phreakwiz/SNES-AddOn-PCBs/Classic_Multiregion_Mod_QID/Overview.JPG

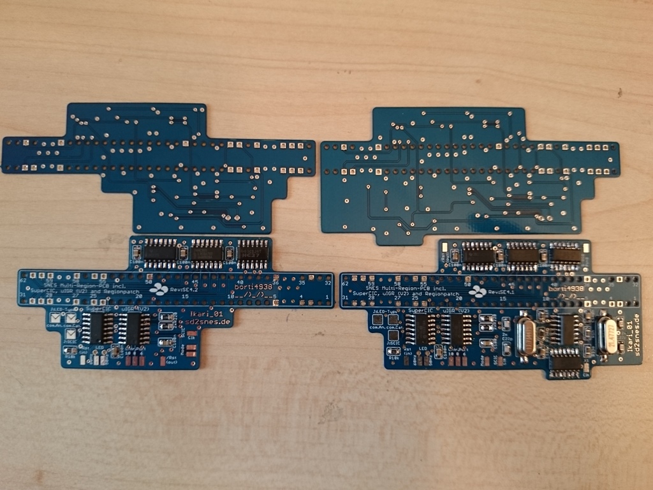
Classic_Multiregion_Mod_QID/Overview.JPG
