phreakwiz/SNES-AddOn-PCBs/RGB Bypass/3Chip-SNES/RGB_SNES.JPG

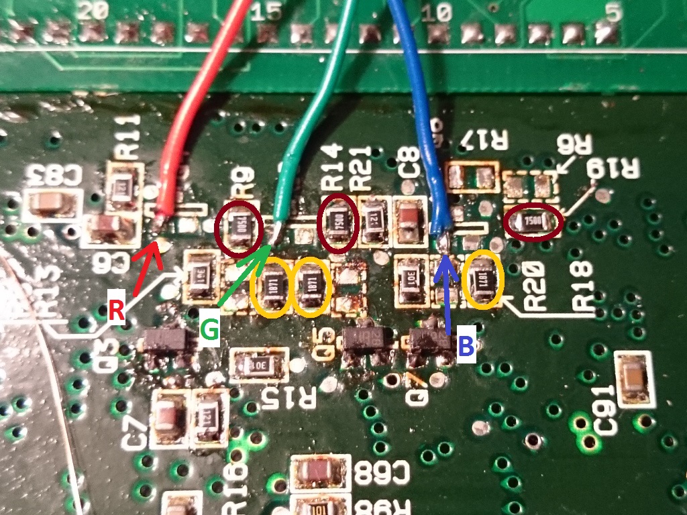
RGB Bypass/3Chip-SNES/RGB_SNES.JPG
