phreakwiz/SNES-AddOn-PCBs/MultiRegion_with_DeJitter_QID/BOM.xlsx

Sheet: SMR20200325
Version: | SMR20200325
Number of PCBs: |  |  | 3
Designator | MPN | QTY/PCB | QTY | DESCRIPTION | VALUE | PACKAGE | NOTES | Digikey | Mouser | Firmware
U1 | PIC16F630-I/SL | 1 | 3 | 8bit Microcontroller |  | SOIC-14 | needs SuperCIC-lock firmware preflashed |  |  | http://sd2snes.de/files/supercic.zip
U2 | PIC16F684-I/SL | 1 | 3 | 8bit Microcontroller |  | SOIC-14 | needs uIGR FW preflashed |  |  | https://github.com/borti4938/Switchless-Mods/tree/master/SNES/uigr_16f684
U3 | EPM7032AETC44-10N | 1 | 3 | CPLD, 32MCs, 3.3Vcc, 5V tolerant I/Os |  | TQFP44 | fw can be flashed using JTAG header |  |  | https://github.com/borti4938/snes_dejitter/tree/regionpatch%2Bdejitter/output_files
U4 | 74HCT2G125DP | 1 | 3 | IC BUFFER NON-INVERT with /OE |  | TSSOP8, SOT505-2
U5 | CDCE913PWR | 1 | 3 | IC PROG PLL VCXO CLK SYN |  | 14TSSOP | I2C accessable over PCB header |  |  | https://github.com/borti4938/SNES-AddOn-PCBs/tree/master/MultiRegion_with_DeJitter_QID/dfo/clockpro
U6 | SN74LVC2G17DBVR | 1 | 3 | IC BUFFER NON-INVERT, Schmitt Trigger |  | SOT-23-6
U7 | TLV70033DDCR | 1 | 3 | LDO 3.3V |  | SOT-23-5
U8 | TLV70018DDCR | 1 | 3 | LDO 1.8V |  | SOT-23-5
U9 | TSH122ICT | 1 | 3 | Video Driver, 6dB, 1 Ch. |  | SC-70-6
X1 | 9C-27.000MAAJ-T | 1 | 3 | CRYSTAL 27.0000MHZ 18PF | 27MHz | HC-49/US
C1,C94 | (22uF cap 0603) | 2 | 6 | Ceramic capacitor, X5R | 22uF / 16V | SMD0603
C11,C21,C31,C32,C33,C34,C41,C51,C52,C61 | (100nF cap 0603) | 10 | 30 | Ceramic capacitor, X7R | 0.1uF / 50V | SMD0603
C71,C72,C81,C82 | (1uF cap 0603) | 4 | 12 | Ceramic capacitor, X5R | 1uF / 6.3V | SMD0603
C91 | (10uF cap 0603) | 1 | 3 | Ceramic capacitor, X5R | 10uF / 25V | SMD0603
C92 | (10nF cap 0603) | 1 | 3 | Ceramic capacitor, X7R | 0.01uF / 50V | SMD0603
C93 | (33uF cap 0805) | 1 | 3 | Ceramic capacitor, X5R | 33uF / 5V | SMD0805
FB1,FB51 | MPZ1608S221A | 2 | 6 | Ferrit bead, power line |  | SMD0603
R11,R21,R32,R38,R39,R52,R63 | RC0603FR-0710KL | 7 | 21 | Resistor | 10k | SMD0603
R22,R23 | RC0603FR-07180RL | 2 | 6 | Resistor | 180 | SMD0603
R31,R37 | RC0603FR-071KL | 2 | 6 | Resistor | 1k | SMD0603
R51 | RC0603FR-0722KL | 1 | 3 | Resistor | 22k | SMD0603
R53,R54,R61 | RC0603FR-0739RL | 3 | 9 | Resistor | 39 | SMD0603
R62 |  | 0 | 0 | Resistor / Jumper |  | SMD0805 | resistor taken from SNES mainboard / jumper closed, if CClk.o directly connected to SNES
R91 | RC0603FR-074K7L | 1 | 3 | Resistor | 4.7k | SMD0603
R92 | RC0603FR-076K19L | 1 | 3 | Resistor | 6.19k | SMD0603
R93 | RC0603FR-07523RL | 1 | 3 | Resistor | 523 | SMD0603
R94 | RC0603FR-0775RL | 1 | 3 | Resistor | 75 | SMD0603
Optional components
(LED) | WP59SURKSGW | 1 | 3 | example replacement LED bi-color with common cathode | red / green
(pin header for LED connection) | 61900211021 | 1 | 3 | pin header for LED connection
 | 61900211621 | 1 | 3 | connector housing 2-pos. Female 2.54mm
 | 61900113722DEC | 2 | 6 | connector socket for 22-28AWG crimp

Sheet: SMR20190813
Version: | SMR20190813
Number of PCBs: |  |  | 3
Designator | MPN | QTY/PCB | QTY | DESCRIPTION | VALUE | PACKAGE | NOTES | Digikey | Mouser | Firmware
U1 | PIC16F630-I/SL | 1 | 3 | 8bit Microcontroller |  | SOIC-14 | needs SuperCIC-lock firmware preflashed |  |  | http://sd2snes.de/files/supercic.zip
U2 | PIC16F684-I/SL | 1 | 3 | 8bit Microcontroller |  | SOIC-14 | needs uIGR FW preflashed |  |  | https://github.com/borti4938/Switchless-Mods/tree/master/SNES/uigr_16f684
U3 | EPM7032AETC44-10N | 1 | 3 | CPLD, 32MCs, 3.3Vcc, 5V tolerant I/Os |  | TQFP44 | fw can be flashed using JTAG header |  |  | https://github.com/borti4938/snes_dejitter/tree/regionpatch%2Bdejitter/output_files
U4 | 74HCT2G125DP | 1 | 3 | IC BUFFER NON-INVERT with /OE |  | TSSOP8, SOT505-2
U5 | CDCE913PWR | 1 | 3 | IC PROG PLL VCXO CLK SYN |  | 14TSSOP | I2C accessable over PCB header |  |  | https://github.com/borti4938/SNES-AddOn-PCBs/tree/master/MultiRegion_with_DeJitter_QID/dfo/clockpro
U6 | SN74LVC2G17DBVR | 1 | 3 | IC BUFFER NON-INVERT, Schmitt Trigger |  | SOT-23-6
U7 | TLV70033DDCR | 1 | 3 | LDO 3.3V |  | SOT-23-5
U8 | TLV70018DDCR | 1 | 3 | LDO 1.8V |  | SOT-23-5
Q31 | 2SC2412KT146R | 1 | 3 | TRANS NPN 50V 0.15A |  | TO-236-3, SC-59, SOT-23-3
X1 | 9C-27.000MAAJ-T | 1 | 3 | CRYSTAL 27.0000MHZ 18PF | 27MHz | HC-49/US
C1 | (22uF cap 0805) | 1 | 3 | Ceramic capacitor, X5R | 22uF / 16V | SMD0805
C11,C21,C31,C32,C33,C34,C41,C51,C52,C61 | (100nF cap 0603) | 10 | 30 | Ceramic capacitor, X7R | 0.1uF / 50V | SMD0603
C71,C72,C81,C82 | (1uF cap 0603) | 4 | 12 | Ceramic capacitor, X5R | 1uF / 6.3V | SMD0603
FB1,FB51 | MPZ1608S221A | 2 | 6 | Ferrit bead, power line |  | SMD0603
R11,R21,R32,R34,R38,R39,R52 | RC0603FR-0710KL | 7 | 21 | Resistor | 10k | SMD0603
R22,R23 | RC0603FR-07180RL | 2 | 6 | Resistor | 180 | SMD0603
R31,R33,R37 | RC0603FR-071KL | 3 | 9 | Resistor | 1k | SMD0603
R35 | RC0603FR-07300RL | 1 | 3 | Resistor | 300 | SMD0603
R36 | RC0603FR-07100RL | 1 | 3 | Resistor | 100 | SMD0603
R51 | RC0603FR-0722KL | 1 | 3 | Resistor | 22k | SMD0603
R53,R54,R61 | RC0603FR-0739RL | 3 | 9 | Resistor | 39 | SMD0603
R62 |  | 0 | 0 | Resistor / Jumper |  | SMD0805 | resistor taken from SNES mainboard / jumper closed, if CClk.o directly connected to SNES
Optional components
(LED) | WP59SURKSGW | 1 | 3 | example replacement LED bi-color with common cathode | red / green
(pin header for LED connection) | 61900211021 | 1 | 3 | pin header for LED connection
 | 61900211621 | 1 | 3 | connector housing 2-pos. Female 2.54mm
 | 61900113722DEC | 2 | 6 | connector socket for 22-28AWG crimp

Sheet: SMR20190603
Version: | SMR20190603 | (and earlier)
Number of PCBs: |  |  | 3
Designator | MPN | QTY/PCB | QTY | DESCRIPTION | VALUE | PACKAGE | NOTES | Digikey | Mouser | Firmware
U1 | PIC16F630-I/SL | 1 | 3 | 8bit Microcontroller |  | SOIC-14 | needs SuperCIC-lock firmware preflashed |  |  | http://sd2snes.de/files/supercic.zip
U2 | PIC16F684-I/SL | 1 | 3 | 8bit Microcontroller |  | SOIC-14 | needs uIGR FW preflashed |  |  | https://github.com/borti4938/Switchless-Mods/tree/master/SNES/uigr_16f684
U3 | EPM7032AETC44-10N | 1 | 3 | CPLD, 32MCs, 3.3Vcc, 5V tolerant I/Os |  | TQFP44 | fw can be flashed using JTAG header |  |  | https://github.com/borti4938/snes_dejitter/tree/regionpatch%2Bdejitter/output_files
U4 | 74HCT2G125DP | 1 | 3 | IC BUFFER NON-INVERT with /OE |  | TSSOP8, SOT505-2
U5 | CDCE913PWR | 1 | 3 | IC PROG PLL VCXO CLK SYN |  | 14TSSOP | I2C accessable over PCB header |  |  | https://github.com/borti4938/SNES-AddOn-PCBs/tree/master/MultiRegion_with_DeJitter_QID/dfo/clockpro
U6 | SN74LVC2G17DBVR | 1 | 3 | IC BUFFER NON-INVERT, Schmitt Trigger |  | SOT-23-6
U7 | TLV70033DDCR | 1 | 3 | LDO 3.3V |  | SOT-23-5
U8 | TLV70018DDCR | 1 | 3 | LDO 1.8V |  | SOT-23-5
Q31 | 2SC2412KT146R | 1 | 3 | TRANS NPN 50V 0.15A |  | TO-236-3, SC-59, SOT-23-3
X1 | 9C-27.000MAAJ-T | 1 | 3 | CRYSTAL 27.0000MHZ 18PF | 27MHz | HC-49/US
C1 | (22uF cap 0805) | 1 | 3 | Ceramic capacitor, X5R | 22uF / 16V | SMD0805
C11,C21,C31,C32,C33,C34,C41,C51,C52,C61 | (100nF cap 0603) | 10 | 30 | Ceramic capacitor, X7R | 0.1uF / 50V | SMD0603
C71,C72,C81,C82 | (1uF cap 0603) | 4 | 12 | Ceramic capacitor, X5R | 1uF / 6.3V | SMD0603
FB1,FB51 | MPZ1608S221A | 2 | 6 | Ferrit bead, power line |  | SMD0603
R11,R21,R32,R34,R38,R39,R52 | RC0603FR-0710KL | 7 | 21 | Resistor | 10k | SMD0603
R22,R23 | RC0603FR-07180RL | 2 | 6 | Resistor | 180 | SMD0603
R31,R33,R37 | RC0603FR-071KL | 3 | 9 | Resistor | 1k | SMD0603
R35 | RC0603FR-07300RL | 1 | 3 | Resistor | 300 | SMD0603
R36 | RC0603FR-07100RL | 1 | 3 | Resistor | 100 | SMD0603
R51 | RC0603FR-0722KL | 1 | 3 | Resistor | 22k | SMD0603
RN53,RN61 | CAY16-39R0F4LF | 2 | 6 | Resistor-Array | 39 | SMD1206 | Alternatives with 5% tolerance are sufficient
Optional components
(LED) | WP59SURKSGW | 1 | 3 | example replacement LED bi-color with common cathode | red / green
(pin header for LED connection) | 61900211021 | 1 | 3 | pin header for LED connection
 | 61900211621 | 1 | 3 | connector housing 2-pos. Female 2.54mm
 | 61900113722DEC | 2 | 6 | connector socket for 22-28AWG crimp
