phreakwiz/SNES-AddOn-PCBs/RGB Bypass/BOM_SNES_RGB_bypass.xlsx

Sheet: SNES_RGBAmp
Designator | MPN | QTY | DESCRIPTION | VALUE | PACKAGE | NOTES
U1 | THS7374IPWR | 1 | 4Ch. Video Amp with SD-filters (selectable) |  | 14TSSOP
 | THS7373IPWR |  | 4Ch. Video Amp with one SD-filte and three HD-filters (selectable) |  | 14TSSOP | Alternative to THS7374
 | THS7314DR |  | 3Ch. SD Video Amp |  | 8-SOIC | Alternative to THS7374 (not recommended)
 | THS7316 |  | 3Ch. HD Video Amp |  | 8-SOIC | Alternative to THS7374 (not recommended)
C1 | GRM188R71H104KA93J | 1 | Ceramic capacitor, X7R | 0.1uF +/- 10% / 50V | SMD0603
C2 | GRM31CR60J226KE19L | 1 | Ceramic capacitor, X5R | 22uF +/- 10% / 6.3V | SMD1206
 | TAJB226K020RNJ |  | Tantalum capacitor | 22uF +/- 10% / 20V | SMD1411 | 3.50mm x 2.80mm, alternative to ceramic 22uF capacitor
R1 | RC0603FR-074K99L | 1 | Resistor | 4.99kOhm, 0.1W | SMD0603 | Non-critical value: other values around 4.99k can be used
C11,C21,C31 | C0603C823K4RACTU | 3 | Ceramic capacitor, X7R | 0.082uF +/- 10% / 16V | SMD0603
R12,R22,R32 | CRCW06035M10FKEA | 3 | Resistor | 5.1MOhm, 0.1W | SMD0603
R13,R23,R33 | RC0603FR-0775RL | 3 | Resistor | 75Ohm, 0.1W | SMD0603 | For NTSC cable setup
 | RC0603FR-0739RL |  | Resistor | 39Ohm, 0.1W | SMD0603 | Alternative for PAL cable setup
C14,C24,C34 | CL10C470JB8NNNC | see readme | Ceramic capacitor, C0G/NP0 | 47pF +/-5% / 50V | SMD0603 | Decoupling caps on modding board
R11,R21,R31 | RC0603FR-07750RL | see readme | Resistor | 750Ohm, 0.1W | SMD0603 | Resolving brightness issue (common choice for big model 1Chip)
 | RC0603FR-071K2L |  |  | 1.2kOhm, 0.1W |  | Resolving brightness issue (common choice for SNES2 (Mini/Jr.))
MPNs are only suggestions! You can use equivalent components, too.

Sheet: SNES_RGBAmp_wCSYNC
Designator | MPN | QTY | DESCRIPTION | VALUE | PACKAGE | NOTES
U1 | THS7374IPWR | 1 | 4Ch. Video Amp with SD-filters (selectable) |  | 14TSSOP
 | THS7373IPWR |  | 4Ch. Video Amp with one SD-filte and three HD-filters (selectable) |  | 14TSSOP | Alternative to THS7374
C1 | GRM188R71H104KA93J | 1 | Ceramic capacitor, X7R | 0.1uF +/- 10% / 50V | SMD0603
C2 | GRM31CR60J226KE19L | 1 | Ceramic capacitor, X5R | 22uF +/- 10% / 6.3V | SMD1206
 | TAJB226K020RNJ |  | Tantalum capacitor | 22uF +/- 10% / 20V | SMD1411 | 3.50mm x 2.80mm, alternative to ceramic 22uF capacitor
R1 | RC0603FR-074K99L | 1 | Resistor | 4.99kOhm, 0.1W | SMD0603 | Non-critical value: other values around 4.99k can be used
C11,C21,C31 | C0603C823K4RACTU | 3 | Ceramic capacitor, X7R | 0.082uF +/- 10% / 16V | SMD0603
R12,R22,R32 | CRCW06035M10FKEA | 3 | Resistor | 5.1MOhm, 0.1W | SMD0603
R13,R23,R33 | RC0603FR-0775RL | 3 | Resistor | 75Ohm, 0.1W | SMD0603 | For NTSC cable setup
 | RC0603FR-0739RL |  | Resistor | 39Ohm, 0.1W | SMD0603 | Alternative for PAL cable setup
C14,C24,C34 | CL10C470JB8NNNC | see readme | Ceramic capacitor, C0G/NP0 | 47pF +/-5% / 50V | SMD0603 | Decoupling caps on modding board
R11,R21,R31 | RC0603FR-07750RL | see readme | Resistor | 750Ohm, 0.1W | SMD0603 | Resolving brightness issue (common choice for big model 1Chip)
 | RC0603FR-071K2L |  |  | 1.2kOhm, 0.1W |  | Resolving brightness issue (common choice for SNES2 (Mini/Jr.))
/CSYNC branch: 75ohm compatible setup (see notes in readme)
R41 | RC0603FR-079K53L | 1 | Resistor | 9.53kOhm, 0.1W | SMD0603
R42 | RC0603FR-07620RL | 1 | Resistor | 620Ohm, 0.1W | SMD0603
C43 | T491D337K006AT | 1 | Tantalum capacitor | 330uF +/- 10% / 6.3V | SMD2917 | 7,30 mm x 4,30 mm
 | T491D227K006AT | 1 | Tantalum capacitor | 220uF +/- 10% / 6.3V | SMD2917 | 7,30 mm x 4,30 mm, alternative to the 330uF tantalum capacitor
R43 | RC0603FR-0775RL | 1 | Resistor | 75Ohm, 0.1W | SMD0603
C44 | CL10C470JB8NNNC | see readme | Ceramic capacitor, C0G/NP0 | 47pF +/-5% / 50V | SMD0603 | Decoupling caps on modding board
/CSYNC branch: TTL compatible setup (see notes in readme)
R41 | RC0603FR-074K99L | 1 | Resistor | 4.99kOhm, 0.1W | SMD0603
R42 | RC0603FR-074K3L | 1 | Resistor | 4.30kOhm, 0.1W | SMD0603
C43 |  |  |  |  |  | Short with J2
R43 | RC0603FR-0775RL | 1 | Resistor | 75Ohm, 0.1W | SMD0603
 | Short |  |  |  |  | Alternative to the 75Ohm resistor
C44 | CL10C470JB8NNNC | see readme | Ceramic capacitor, C0G/NP0 | 47pF +/-5% / 50V | SMD0603 | Decoupling caps on modding board
MPNs are only suggestions! You can use equivalent components, too.

Sheet: SNES_RGBAmp_wCSYNC_SVid
Designator | MPN | QTY | DESCRIPTION | VALUE | PACKAGE | NOTES
U1 | THS7374IPWR | 1 | 4Ch. Video Amp with SD-filters (selectable) |  | 14TSSOP
 | THS7373IPWR |  | 4Ch. Video Amp with one SD-filte and three HD-filters (selectable) |  | 14TSSOP | Alternative to THS7374
C1 | GRM188R71H104KA93J | 1 | Ceramic capacitor, X7R | 0.1uF +/- 10% / 50V | SMD0603
C2 | GRM31CR60J226KE19L | 1 | Ceramic capacitor, X5R | 22uF +/- 10% / 6.3V | SMD1206
 | TAJB226K020RNJ |  | Tantalum capacitor | 22uF +/- 10% / 20V | SMD1411 | 3.50mm x 2.80mm, alternative to ceramic 22uF capacitor
R1 | RC0603FR-074K99L | 1 | Resistor | 4.99kOhm, 0.1W | SMD0603 | Non-critical value: other values around 4.99k can be used
C11,C21,C31 | C0603C823K4RACTU | 3 | Ceramic capacitor, X7R | 0.082uF +/- 10% / 16V | SMD0603
R12,R22,R32 | CRCW06035M10FKEA | 3 | Resistor | 5.1MOhm, 0.1W | SMD0603
R13,R23,R33 | RC0603FR-0775RL | 3 | Resistor | 75Ohm, 0.1W | SMD0603 | For NTSC cable setup
 | RC0603FR-0739RL |  | Resistor | 39Ohm, 0.1W | SMD0603 | Alternative for PAL cable setup
C14,C24,C34 | CL10C470JB8NNNC | see readme | Ceramic capacitor, C0G/NP0 | 47pF +/-5% / 50V | SMD0603 | Decoupling caps on modding board
R11,R21,R31 | RC0603FR-07750RL | see readme | Resistor | 750Ohm, 0.1W | SMD0603 | Resolving brightness issue (common choice for big model 1Chip)
 | RC0603FR-071K2L |  |  | 1.2kOhm, 0.1W |  | Resolving brightness issue (common choice for SNES2 (Mini/Jr.))
/CSYNC branch: 75ohm compatible setup (see notes in readme)
R41 | RC0603FR-079K53L | 1 | Resistor | 9.53kOhm, 0.1W | SMD0603
R42 | RC0603FR-07620RL | 1 | Resistor | 620Ohm, 0.1W | SMD0603
C43 | T491D337K006AT | 1 | Tantalum capacitor | 330uF +/- 10% / 6.3V | SMD2917 | 7,30 mm x 4,30 mm
 | T491D227K006AT | 1 | Tantalum capacitor | 220uF +/- 10% / 6.3V | SMD2917 | 7,30 mm x 4,30 mm, alternative to the 330uF tantalum capacitor
R43 | RC0603FR-0775RL | 1 | Resistor | 75Ohm, 0.1W | SMD0603
C44 | CL10C470JB8NNNC | see readme | Ceramic capacitor, C0G/NP0 | 47pF +/-5% / 50V | SMD0603 | Decoupling caps on modding board
/CSYNC branch: TTL compatible setup (see notes in readme)
R41 | RC0603FR-074K99L | 1 | Resistor | 4.99kOhm, 0.1W | SMD0603
R42 | RC0603FR-074K3L | 1 | Resistor | 4.30kOhm, 0.1W | SMD0603
C43 |  |  |  |  |  | Short with J2
R43 | RC0603FR-0775RL | 1 | Resistor | 75Ohm, 0.1W | SMD0603
 | Short |  |  |  |  | Alternative to the 75Ohm resistor
C44 | CL10C470JB8NNNC | see readme | Ceramic capacitor, C0G/NP0 | 47pF +/-5% / 50V | SMD0603 | Decoupling caps on modding board
S-Video branch:
R53,R63 | RC0603FR-0775RL | 2 | Resistor | 75Ohm, 0.1W | SMD0603 | For NTSC cable setup
 | RC0603FR-0739RL |  | Resistor | 39Ohm, 0.1W | SMD0603 | Alternative for PAL cable setup
C53 | T491D227K006AT | 1 | Tantalum capacitor | 220uF +/- 10% / 6.3V | SMD2917 | 7,30 mm x 4,30 mm
 | T491D337K006AT | 1 | Tantalum capacitor | 330uF +/- 10% / 6.3V | SMD2917 | 7,30 mm x 4,30 mm, alternative for the 220uF
C63 | GRM188R71H104KA93J | 1 | Ceramic capacitor, X7R | 0.1uF +/- 10% / 50V | SMD0603
C54,C64 | CL10C470JB8NNNC | see readme | Ceramic capacitor, C0G/NP0 | 47pF +/-5% / 50V | SMD0603 | Decoupling caps on modding board
MPNs are only suggestions! You can use equivalent components, too.
