phreakwiz/SNES-AddOn-PCBs/digAudio/BOM.xlsx

Sheet: OC0808
Designator | MPN | QTY | DESCRIPTION | VALUE | PACKAGE | NOTES
U1 | DIT4096IPW | 1 | 96kHz Audio Transmitter |  | TSSOP-28
JT OC0808 | FCR684208T | 1 | Toslink Transmitter |  | OTJ-8 | Designator name from former version
 |  |  |  |  |  | available at conrad.de e.g.: https://www.conrad.de/de/lwl-steckverbinder-cliff-fcr684208t-toslink-sender-606379.html
C1,C2,C3 | GRM188R71H104KA93J | 3 |  | 0.1uF / 50V | SMD 0603
Spacer / standoff | use M3 spacer | 1 | length between 7mm and 8mm |  |  | depending on your cutout
Washer |  | x |  |  |  | use washer to adjust standoff and srew fit
Screws |  | 2
MPNs are only suggestions! You can use equivalent components, too.

Sheet: PLT133
Designator | MPN | QTY | DESCRIPTION | VALUE | PACKAGE | NOTES
U1 | DIT4096IPW | 1 | 96kHz Audio Transmitter |  | TSSOP-28
PLT133/T10W | PLT133/T10W | 1 | Toslink Transmitter
C1,C2,C3 | GRM188R71H104KA93J | 3 |  | 0.1uF / 50V | SMD 0603
Spacer / standoff | use M3 spacer | 1 | length between 7mm and 8mm |  |  | depending on your cutout
Washer |  | x |  |  |  | use washer to adjust standoff and srew fit
Screws |  | 2
MPNs are only suggestions! You can use equivalent components, too.

Sheet: RCJ-DA101JC
Designator | MPN | QTY | DESCRIPTION | VALUE | PACKAGE | NOTES
U1 | DIT4096IPW | 1 | 96kHz Audio Transmitter |  | TSSOP-28
C1,C2 | GRM188R71H104KA93J | 2 |  | 0.1uF / 50V | SMD 0603
DA101JC | DA101JC | 1 | Audio transformer |  | SMD-6
For RCA-Setup
RCJ-01x-SMT | RCJ-013-SMT-TR | 1 | RCA connector 9.0mm / 3.2mm |  |  | needs to be trimmed due to PCB thickness to fit nicely
 |  |  |  |  |  | x = color of isolating material
C3 | GRM188R70J103KA01D | 1 |  | 10nF / 50V | SMD0603
R1 | CRCW0603348RFKEA | 1 |  | 347.5ohm / 0.1W | SMD0603
R2 | CRCW060391R0FKEA | 1 |  | 90.9ohm / 0.1W | SMD0603
J1 |  |  |  |  |  | close jumper at upper branch (marked half)
For XLR setup | (untested)
C3 | GRM188R71H104KA93J | 1 |  | 0.1uF / 50V | SMD0603
R1 | CRCW060357R6FKEA | 1 |  | 57ohm /0.1W
R2 |  |  |  |  |  | leave R2 unpopulated
J1 |  |  |  |  |  | close jumper at lower half
XLR | positive |  |  |  |  | connect positive part to middle pad of RCJ-01x-SMT footprint
 | negative |  |  |  |  | connect positive part to left or right pad of RCJ-01x-SMT footprint
MPNs are only suggestions! You can use equivalent components, too.

Sheet: RCJ-tg10da1nslf
Designator | MPN | QTY | DESCRIPTION | VALUE | PACKAGE | NOTES
U1 | DIT4096IPW | 1 | 96kHz Audio Transmitter |  | TSSOP-28
C1,C2 | GRM188R71H104KA93J | 2 |  | 0.1uF / 50V | SMD 0603
TG10-DA1NSLF | TG10-DA1NSLF | 1 | Audio transformer |  | SMD-6
For RCA-Setup
RCJ-01x-SMT | RCJ-013-SMT-TR | 1 | RCA connector 9.0mm / 3.2mm |  |  | needs to be trimmed due to PCB thickness to fit nicely
 |  |  |  |  |  | x = color of isolating material
C3 | GRM188R70J103KA01D | 1 |  | 10nF / 50V | SMD0603
R1 | CRCW0603348RFKEA | 1 |  | 347.5ohm / 0.1W | SMD0603
R2 | CRCW060391R0FKEA | 1 |  | 90.9ohm / 0.1W | SMD0603
J1 |  |  |  |  |  | close jumper at upper branch (marked half)
For XLR setup | (untested)
C3 | GRM188R71H104KA93J | 1 |  | 0.1uF / 50V | SMD0603
R1 | CRCW060357R6FKEA | 1 |  | 57ohm /0.1W
R2 |  |  |  |  |  | leave R2 unpopulated
J1 |  |  |  |  |  | close jumper at lower half
XLR | positive |  |  |  |  | connect positive part to middle pad of RCJ-01x-SMT footprint
 | negative |  |  |  |  | connect positive part to left or right pad of RCJ-01x-SMT footprint
MPNs are only suggestions! You can use equivalent components, too.
