phreakwiz/SNES-AddOn-PCBs/MultiRegion_with_DeJitter_QID/dfo/pcb_programmer/BOM.xlsx

QTY | Description | mouser.com part-no | optional
1x | FT232RL USB UART interface IC | 895-FT232RL
1x | ATMEGA48A microcontroller | 556-ATMEGA48A-AU
1x | Mini USB socket | 587-690-005-299-143
1x | Vt pin header 3pos. 2.54mm | 571-826936-3 | x
1x | Vt shunt 2pos. 2.54mm | 571-8815452 | x
1x | Prog pin header 4pos. 2.54mm | 571-826936-4 | x
1x | uC ICSP pin header 2x3pos. 2.54mm | 571-4-146262-1 | x
1x | 8 MHz crystal | 774-ATS080B
3x | 100 nF capacitor | 80-C0805C104K5R
1x | 4.7 uF capacitor | 581-08053D475K
2x | 18 pF capacitor | 77-VJ0805A180GXJCBC
1x | 330 Ohm resistor | 71-CRCW0805-330-E3
2x | 10 kOhm resistor | 71-CRCW0805J-10K-E3
2x | 4.7 kOhm resistor | 71-CRCW0805-4.7K-E3
1x | LED | 720-LSR976-NR-1
EXAMPLES
