phreakwiz/SNES-AddOn-PCBs/MultiRegion_with_DeJitter_QID/installation/README.md

### Some General Notes

- Installation guides might be incomplete
- Guides does not include _open_ and _close_ the SNES housing
- When routing wires, keep in mind that the SNES housing might not allow the shortest route especially if you route a wire from bottom to top side
- Take your time
- Please read the main [readme](../README.md) first for general notes and explanations.
