phreakwiz/SNES-AddOn-PCBs/MultiRegion_with_DeJitter_QID/installation/SNSP-CPU-01/CIC_Clk.jpg

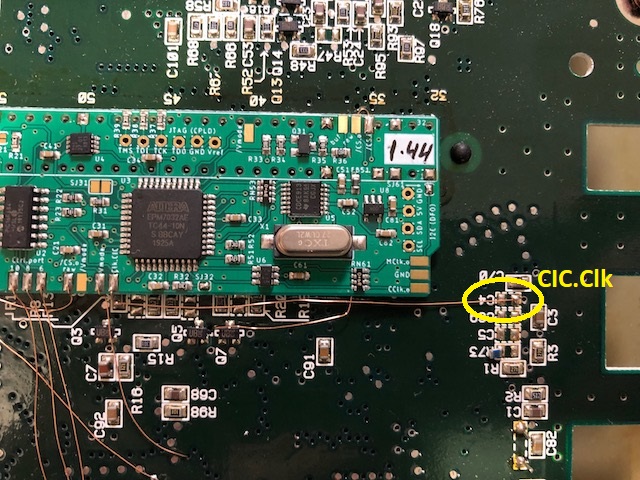
MultiRegion_with_DeJitter_QID/installation/SNSP-CPU-01/CIC_Clk.jpg
