phreakwiz/SNES-AddOn-PCBs/sd2snes_RevH/Installation/00a_OSHPark.JPG

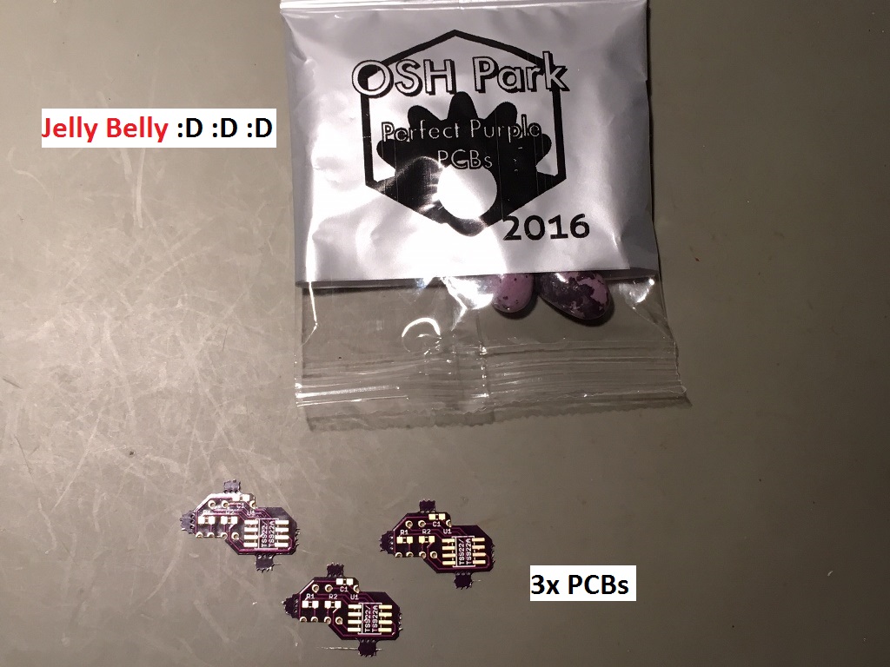
sd2snes_RevH/Installation/00a_OSHPark.JPG
