phreakwiz/SNES-AddOn-PCBs/sd2snes_RevH/Installation/00b_PCB.JPG

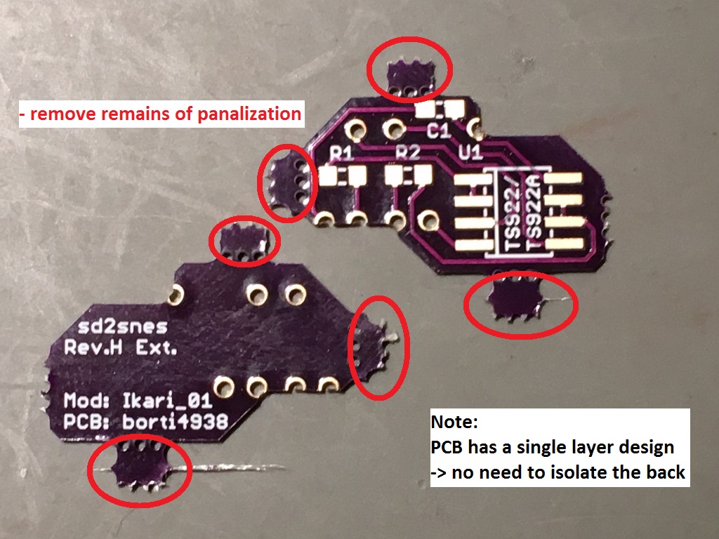
sd2snes_RevH/Installation/00b_PCB.JPG
