phreakwiz/SNES-AddOn-PCBs/sd2snes_RevH/Installation/01_Preparation.JPG

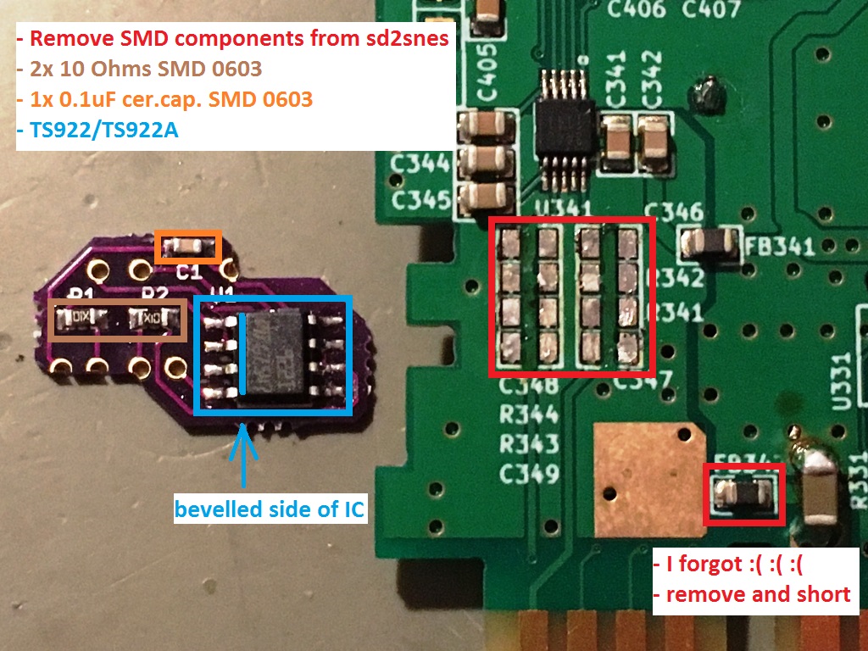
sd2snes_RevH/Installation/01_Preparation.JPG
