phreakwiz/SNES-AddOn-PCBs/sd2snes_RevH/Installation/01_Preparation_RevG.jpg

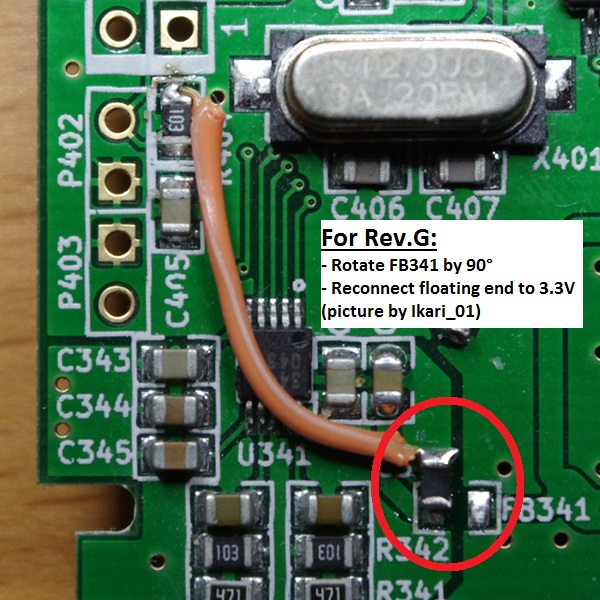
sd2snes_RevH/Installation/01_Preparation_RevG.jpg
