phreakwiz/SNES-AddOn-PCBs/sd2snes_RevH/Installation/02a_Fitting.JPG

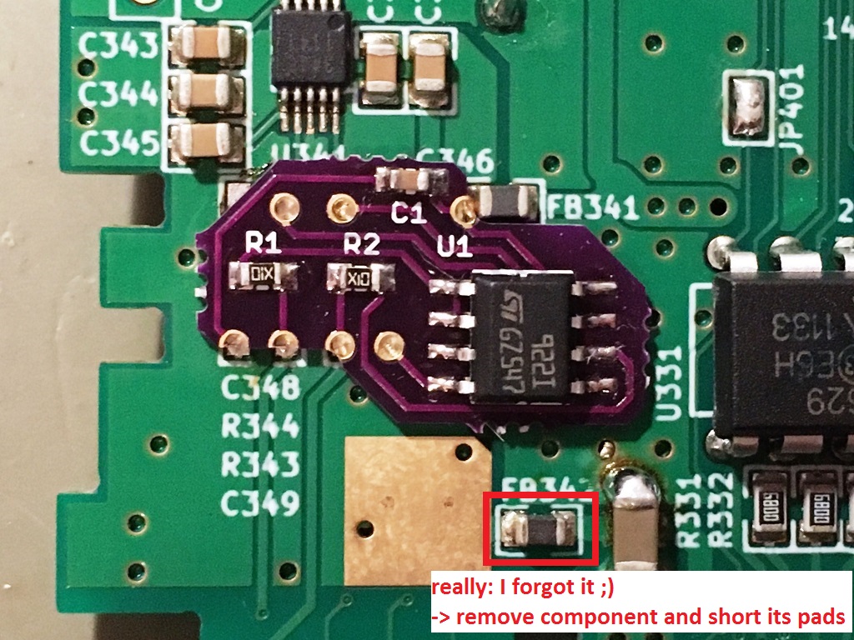
sd2snes_RevH/Installation/02a_Fitting.JPG
