phreakwiz/SNES-AddOn-PCBs/sd2snes_RevH/Installation/02b_Soldering.JPG

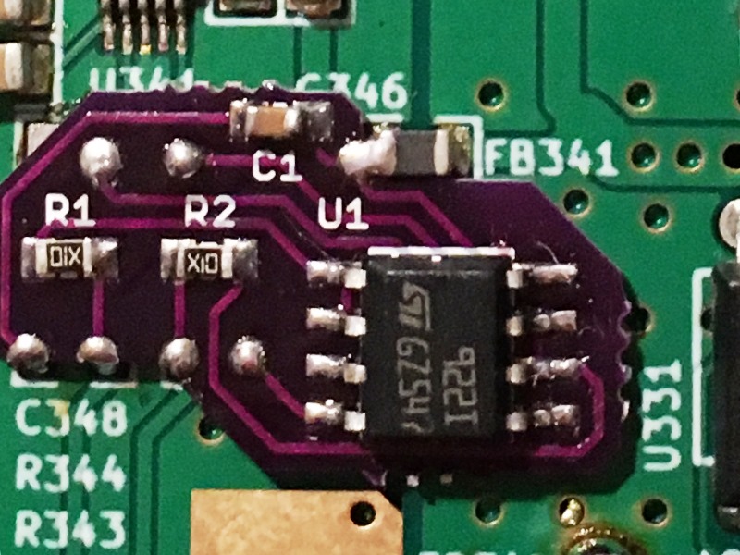
sd2snes_RevH/Installation/02b_Soldering.JPG
