phreakwiz/SNES-AddOn-PCBs/sd2snes_RevH/Installation/03_PCB_soldered_and_check.jpg

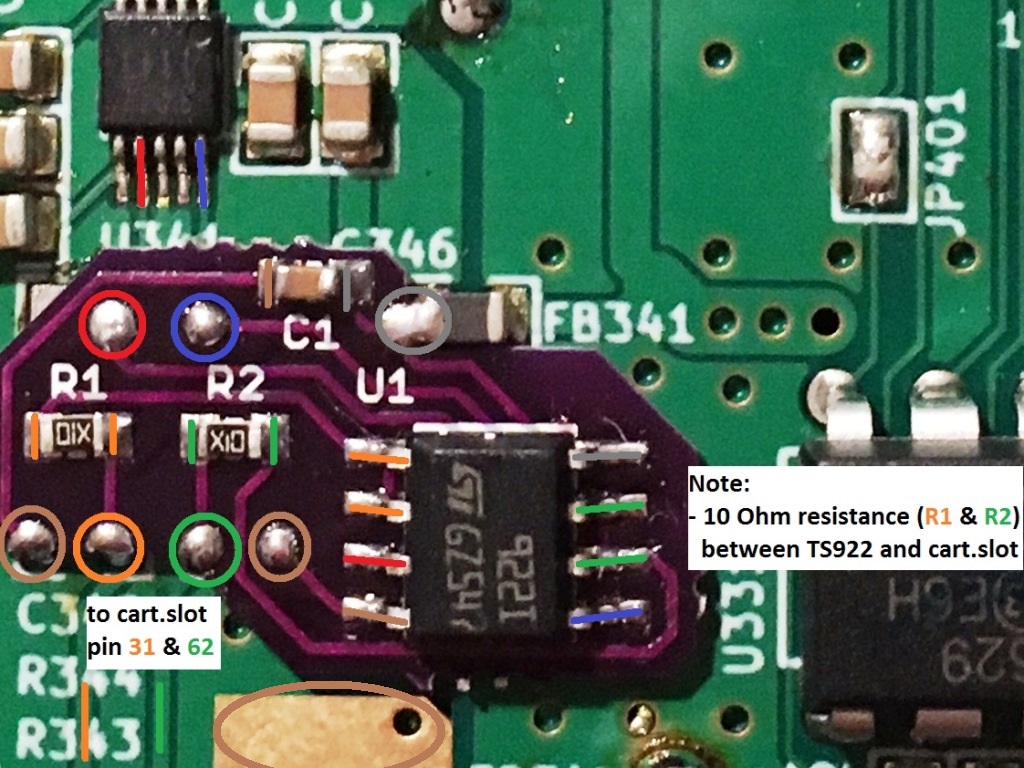
sd2snes_RevH/Installation/03_PCB_soldered_and_check.jpg
