phreakwiz/SNES-AddOn-PCBs/sd2snes_RevH/Installation/04_OptionalStep_HWID.JPG

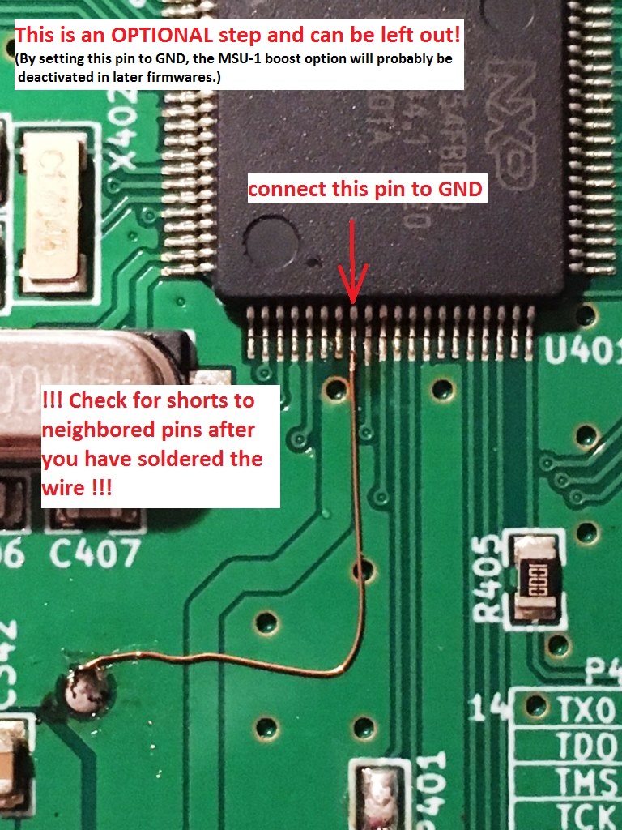
sd2snes_RevH/Installation/04_OptionalStep_HWID.JPG
