phreakwiz/SNES-AddOn-PCBs/RGB Bypass/1Chip-SNES/Issue#3/Post Interference 01.jpg

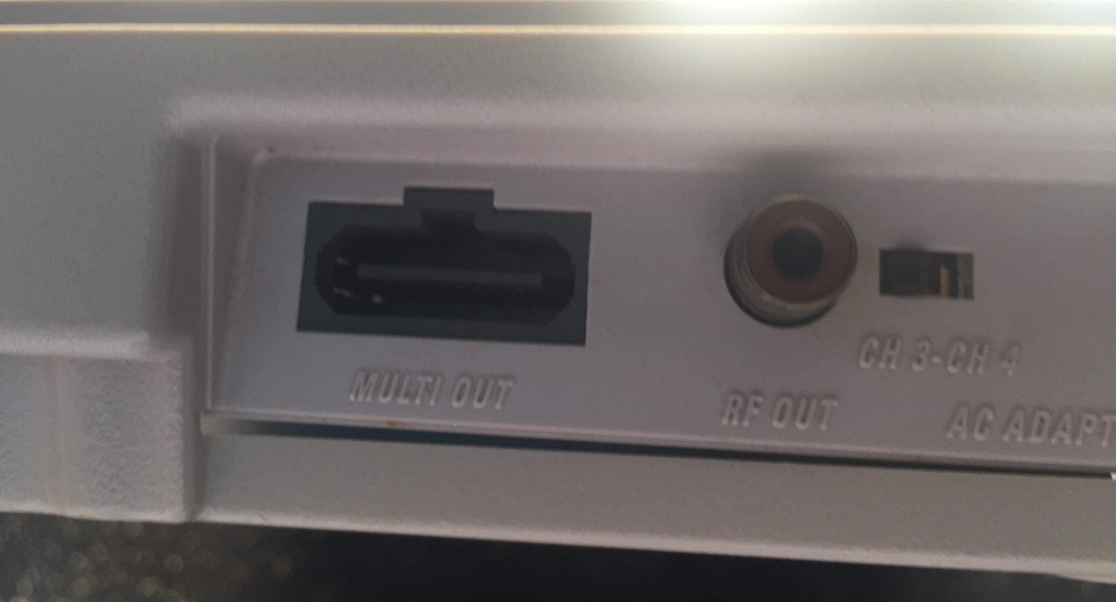
RGB Bypass/1Chip-SNES/Issue#3/Post Interference 01.jpg
