phreakwiz/SNES-AddOn-PCBs/RGB Bypass/1Chip-SNES/Issue#3/Post Interference 02.jpg

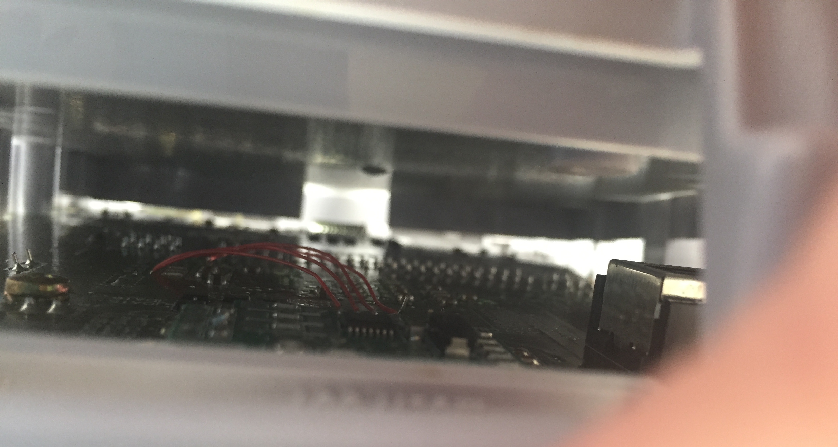
RGB Bypass/1Chip-SNES/Issue#3/Post Interference 02.jpg
