phreakwiz/SNES-AddOn-PCBs/Classic_Multiregion_Mod_QID/SNES-1Chip/KiCad/SNES-1Chip_MR_QID.kicad_pcb

## KiCad design Classic_Multiregion_Mod_QID/SNES-1Chip/KiCad/SNES-1Chip_MR_QID.kicad_pcb (2018-02-12)

Schematic: SNES-1Chip_MR_QID.sch

Parts:
74*00, 74HCU04: 74XX-EU_SO14
74HC(T)125: 74HC125D; 74XX-EU_SO14
C1, C2, C3, C4, C5, C6, C7: C100n; SNESCART_Z0805
C8, C9, C10, C11: C22p; SNESCART_Z0805
CTRL1, CTRL2, CTRL3, CTRL4: WIREPAD_SMD1_27-2_54
IC1: 74HC27D; 74XX-EU_SO14
IC2: 74HC30D; 74XX-EU_SO14
L50, L60: WIREPAD_SMD1_27-2_54
MODE1: WIREPAD_SMD1_27-2_54
NTSC_21.477MHZ1: CRYSTAL_HC49UP
PAL_17.734MHZ1: CRYSTAL_HC49UP
R1: R10k; SNESCART_Z0805
R2, R3: R220; SNESCART_Z0805
R4, R5: R330; SNESCART_Z0805
R6, R7: R1M; SNESCART_Z0805
RES-IN1: WIREPAD_SMD1_27-2_54
RES-OUT1: WIREPAD_SMD1_27-2_54
SRGB9: WIREPAD_SMD1_27-2_54
U$1, U$4, U$5: MY_JUMPER; SNESCART_MYJUMP
U$2, U$3: PIC16F630_SIMPLE; SNESCART_PIC16F630
U$6: SNESCART_CONN_SPARSE; SNES_DIV_SNESCART_CONN_SPARSE
X1: WIREPAD_SMD1_27-2_54

Connections:
/N$2: 74HC(T)125.1 (OE), 74HC(T)125.4 (OE), 74HC(T)125.10 (OE), 74HC(T)125.13 (OE), IC2.8 (O)
/N$4: IC2.3 (I2), U$6.61 (PA5)
/N$5: IC2.2 (I1), U$6.60 (PA3)
/N$6: IC1.3 (I0), U$6.4 (/PARD)
/N$7: IC1.4 (I1), U$6.3 (PA6)
/N$8: IC1.6 (O), IC2.11 (I6)
/N$9: IC2.6 (I5), U$6.28 (PA0)
/N$10: R1.2, RES-IN1.1, U$2.13 (A0), U$3.2 (A5)
/N$11: L50.1, R2.2
/N$12: R2.1, U$3.5 (C5)
/N$13: R3.1, U$3.6 (C4)
/N$15: L60.1, R3.2
/N$16: IC1.5 (I2), U$6.34 (PA7)
/N$17: IC2.12 (I7), U$3.7 (C3)
/N$18: U$1.P$1 (1), U$6.56 (CIC_P6)
/N$19: U$2.5 (C5), U$3.10 (C0)
/N$20: IC2.1 (I0), U$6.59 (PA1)
/N$21: IC2.5 (I4), U$6.29 (PA2)
/N$22: IC2.4 (I3), U$6.30 (PA4)
/N$26: 74*00.12 (I0), 74HCU04.6 (O)
/N$27: 74HCU04.1 (I), C8.1, PAL_17.734MHZ1.1, R6.1
/N$28: 74HCU04.3 (I), C9.1, PAL_17.734MHZ1.2, R4.2, R6.2
/N$29: 74HCU04.13 (I), C10.1, NTSC_21.477MHZ1.1, R7.1
/N$31: 74*00.5 (I1), 74*00.8 (O)
/N$32: 74*00.4 (I0), 74*00.11 (O)
/N$33: CTRL2.1, U$3.11 (A2)
/N$34: CTRL3.1, U$3.12 (A1)
/N$35: 74*00.3 (O), 74*00.9 (I0)
/N$36: 74*00.6 (O), X1.1
/N$37: 74HCU04.2 (O), R4.1
/N$38: 74HCU04.4 (O), 74HCU04.5 (I)
/N$39: CTRL1.1, U$1.P$2 (2), U$2.2 (A5)
/N$41: 74*00.10 (I1), 74HCU04.8 (O)
/N$42: 74HC(T)125.3 (O), 74HC(T)125.6 (O), 74HC(T)125.8 (O), 74HC(T)125.11 (O), U$6.50 (D4)
/N$44: 74HCU04.9 (I), 74HCU04.10 (O)
/N$46: CTRL4.1, U$3.13 (A0)
/N$48: U$2.10 (C0), U$6.55 (CIC_P2)
/N$49: U$2.9 (C1), U$6.24 (CIC_P1)
/N$50: 74HCU04.12 (O), R5.1
/N$51: U$2.8 (C2), U$6.25 (CIC_P7)
/N$52: U$2.6 (C4), U$3.9 (C1)
/N$53: U$2.7 (C3), U$3.8 (C2), U$4.P$2 (2), U$5.P$2 (2)
/UIGR: 74HC(T)125.2 (I), 74HC(T)125.5 (I), 74HC(T)125.9 (I), 74HC(T)125.12 (I), U$2.3 (A4), U$3.4 (A3)
/VCC_2: 74HC(T)125.14 (VCC), C5.1, C6.1, C7.1, IC1.14 (VCC), IC2.14 (VCC), U$6.58 (VCC)
GND: 74*00.7 (GND), 74HC(T)125.7 (GND), 74HCU04.7 (GND), C1.2, C2.2, C3.2, C4.2, C5.2, C6.2, C7.2, C8.2, C9.2, C10.2, C11.2, IC1.1 (I0), IC1.2 (I1), IC1.7 (GND), IC1.9 (I0), IC1.10 (I1), IC1.13 (I2), IC2.7 (GND), R1.1, U$2.4 (A3), U$2.14 (GND), U$3.14 (GND), U$5.P$1 (1), U$6.5 (GND), U$6.36 (GND)
unnamed: IC1.8 (O), SRGB9.1
unnamed: RES-OUT1.1, U$2.11 (A2)
unnamed: 74*00.1 (I0), 74*00.2 (I1), 74*00.13 (I1), IC1.11 (I2), MODE1.1, U$3.3 (A4)
unnamed: 74HCU04.11 (I), C11.1, NTSC_21.477MHZ1.2, R5.2, R7.2
VCC: 74*00.14 (VCC), 74HCU04.14 (VCC), C1.1, C2.1, C3.1, C4.1, U$2.1 (VCC), U$3.1 (VCC), U$4.P$1 (1), U$6.27 (VCC)

Notes on the sheet:
PAL Quarz
NTSC Quarz

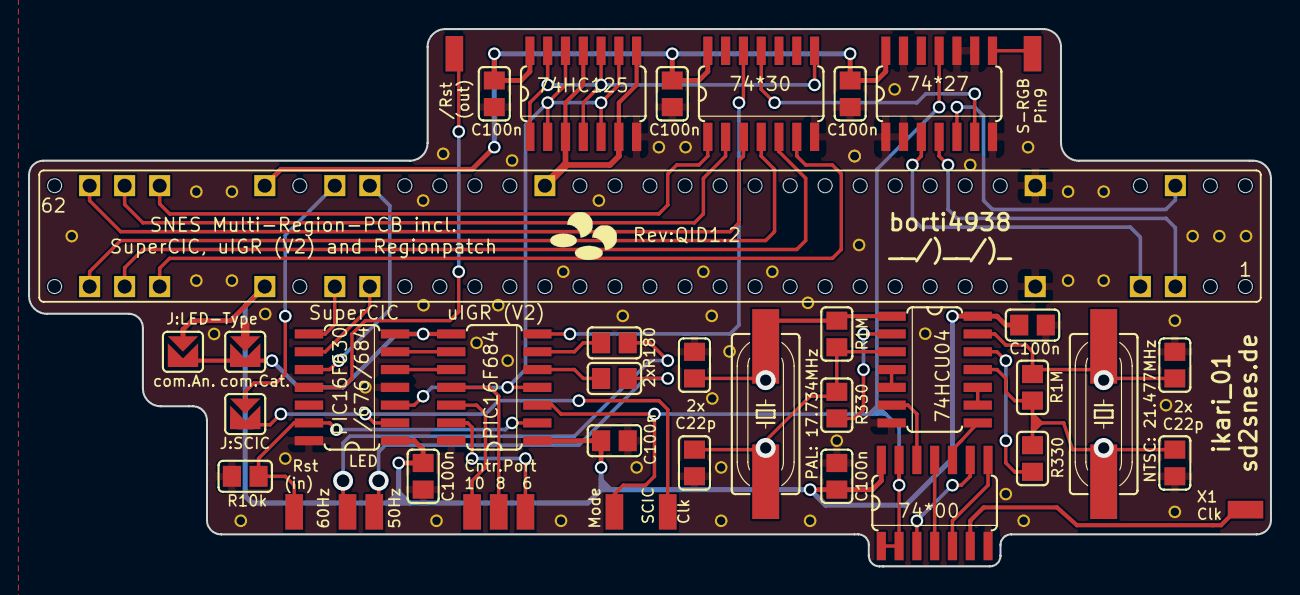
[picture p64: board SNES-1Chip_MR_QID.kicad_pcb from above]

Board: 2 copper layers, 88.6 x 38.4 mm, 42 parts (0 on the bottom side), 50 nets.
