phreakwiz/SNES-AddOn-PCBs/MultiRegion_with_DeJitter_QID/SNES_MR_DeJitter_QID.brd

## EAGLE design MultiRegion_with_DeJitter_QID/SNES_MR_DeJitter_QID.brd (2020-04-05)

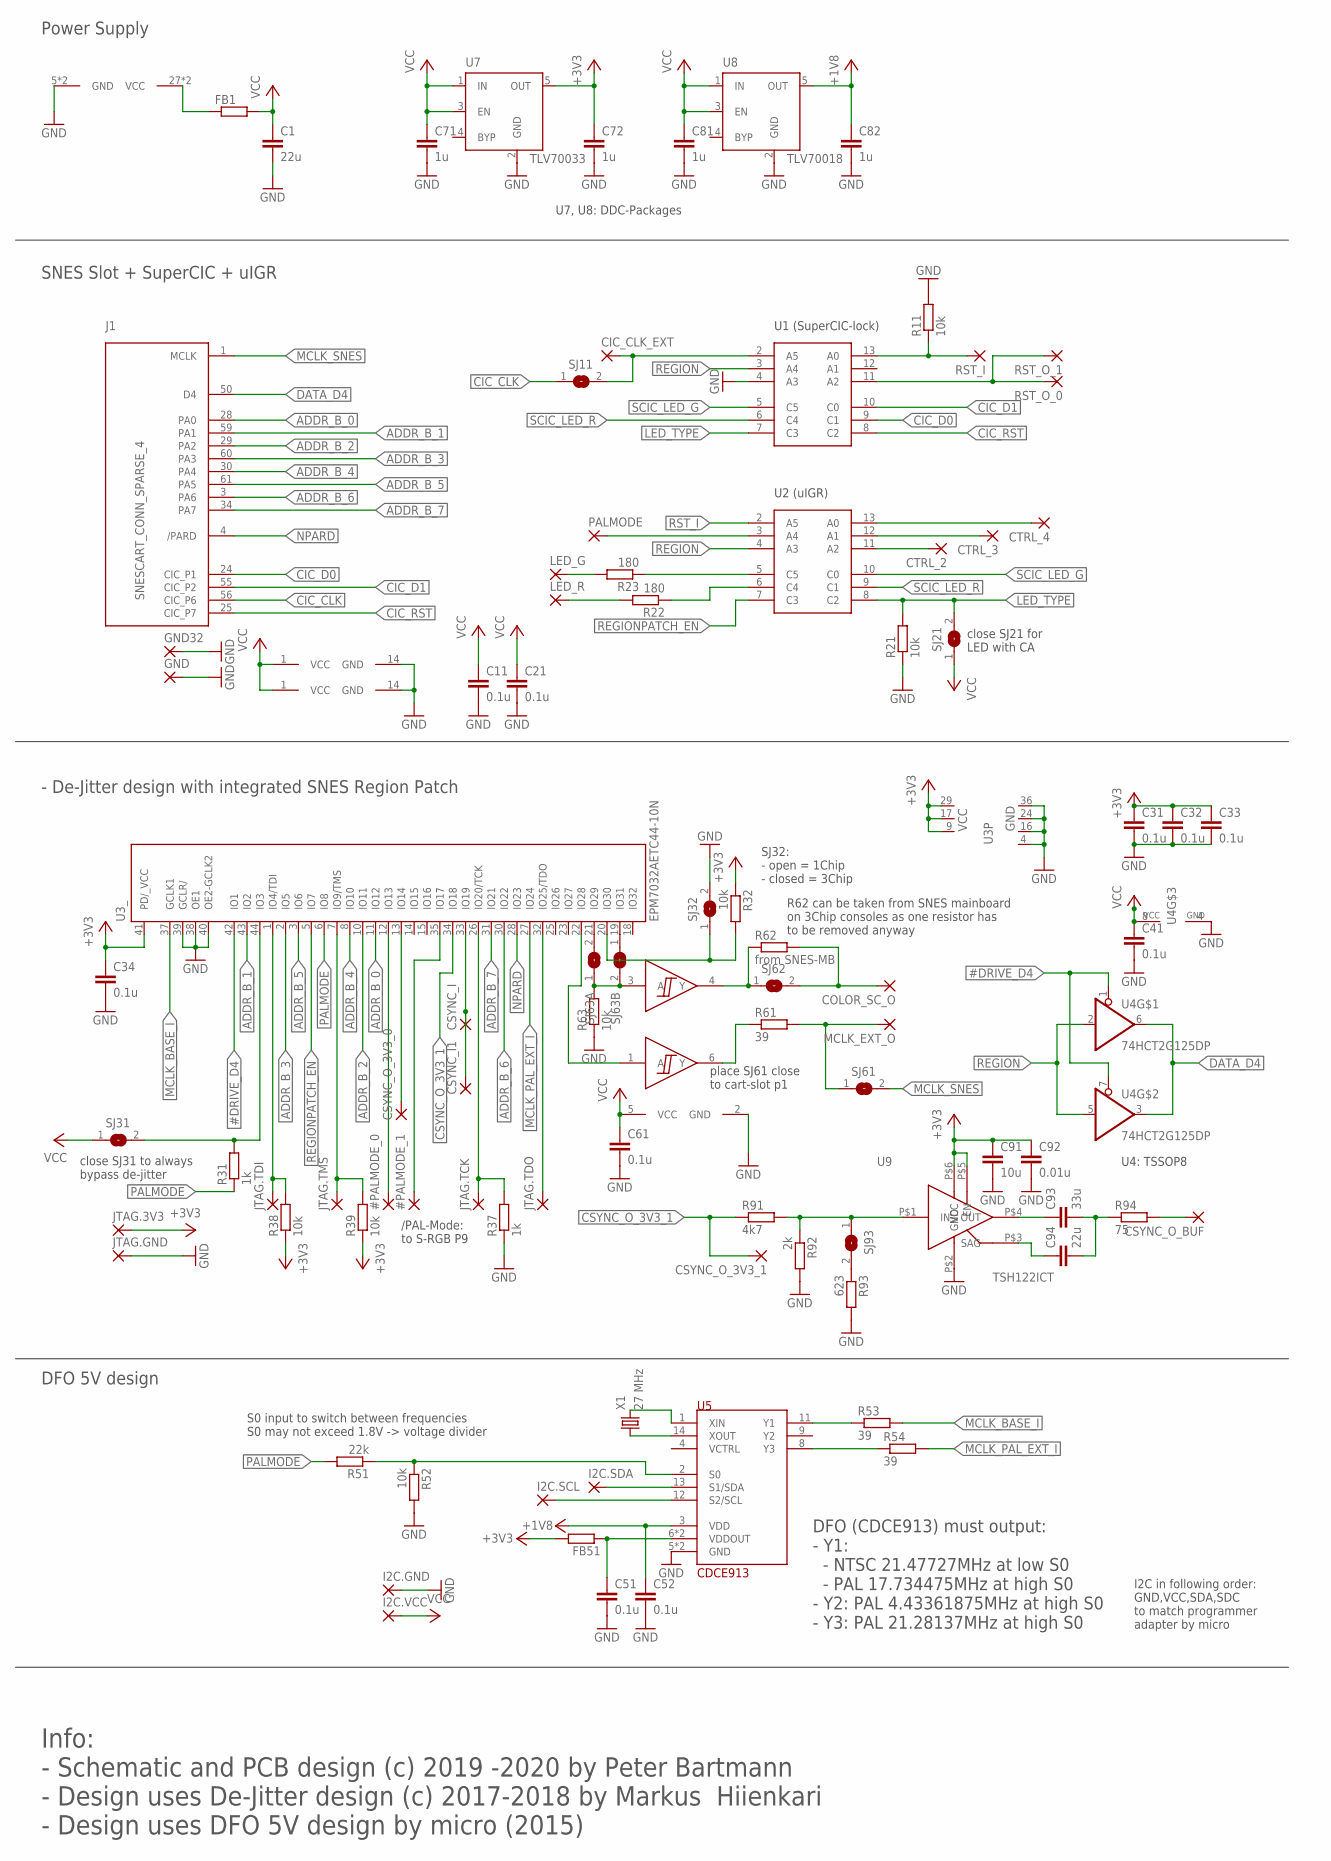
[picture p65: schematic SNES_MR_DeJitter_QID.sch]

Parts:
#PALMODE_0, #PALMODE_1: SMD2; SMD1,27-2,54
C1, C94: 22u; C0603
C11, C21, C31, C32, C33, C34, C41, C51, C52, C61: 0.1u; C0603
C71, C72, C81, C82: 1u; C0603
C91: 10u; C0603
C92: 0.01u; C0603
C93: 33u; C0805
CIC_CLK_EXT: SMD2; SMD1,27-2,54
COLOR_SC_O: SMD2; SMD1,27-2,54
CSYNC_I, CSYNC_I1: SMD2; SMD1,27-2,54
CSYNC_O_3V3_0, CSYNC_O_3V3_1: SMD2; SMD1,27-2,54
CSYNC_O_BUF: SMD2; SMD1,27-2,54
CTRL_2, CTRL_3, CTRL_4: SMD2; SMD1,27-2,54
FB1, FB51: R-EU_R0603; R0603
GND, GND32: SMD2; SMD1,27-2,54
I2C.GND, I2C.SCL, I2C.SDA, I2C.VCC: 1,6/0,8
J1: SNESCART_CONN_SPARSE_4
JTAG.3V3, JTAG.GND, JTAG.TCK, JTAG.TDI, JTAG.TDO, JTAG.TMS: 1,6/0,8
LED_G: SMD2; SMD1,27-2,54
LED_R: SMD2; SMD1,27-2,54
MCLK_EXT_O: SMD2; SMD1,27-2,54
PALMODE: SMD2; SMD1,27-2,54
R11, R21, R32, R38, R39, R52: 10k; R0603
R22, R23: 180; R0603
R31, R37: 1k; R0603
R51: 22k; R0603
R53, R54, R61: 39; R0603
R62: from SNES-MB; R0805
R63: 10k; R0805
R91: 4k7; R0603
R92: 2k; R0603
R93: 623; R0603
R94: 75; R0603
RST_I: SMD2; SMD1,27-2,54
RST_O_0, RST_O_1: SMD2; SMD1,27-2,54
SJ11, SJ21, SJ32, SJ61, SJ62, SJ63A, SJ63B, SJ93: SJSMALL; SJ_SMALL
SJ31: SJ
U1: SuperCIC_lock; PIC16F630
U2: uIGR; PIC16F630
U3: EPM7032AETC44-10N; TQFP44
U4: 74HCT2G125DP; SSOP08
U5: CDCE913; TSSOP14
U6: 2G17TI_DBV; SOT-23-6
U7: TLV70033; SOT23-5
U8: TLV70018; SOT23-5
U9: TSH122ICT; SC70
X1: 27 MHz; HC49UP

Connections:
#DRIVE_D4: U3.42 (IO1), U4.1 (OE), U4.7 (OE)
+1V8: C52.1, C82.1, U5.3 (VDD), U8.5 (OUT)
+3V3: C31.1, C32.1, C33.1, C34.1, C72.1, C91.1, C92.1, FB51.2, JTAG.3V3.1, R32.1, R38.1, R39.1, U3.9 (VCC), U3.17 (VCC), U3.29 (VCC), U3.41 (PD/_VCC), U7.5 (OUT), U9.P$5 (EN), U9.P$6 (VCC)
+5V: C1.1, C11.1, C21.1, C41.1, C61.1, C71.1, C81.1, FB1.2, I2C.VCC.1, SJ21.1, SJ31.1, U1.1 (VCC), U2.1 (VCC), U4.8 (VCC), U6.5 (VCC), U7.1 (IN), U7.3 (EN), U8.1 (IN), U8.3 (EN)
+5V_SNES: FB1.1, J1.27 (VCC), J1.58 (VCC)
ADDR_B_0: J1.28 (PA0), U3.11 (IO12)
ADDR_B_1: J1.59 (PA1), U3.43 (IO2)
ADDR_B_2: J1.29 (PA2), U3.10 (IO11)
ADDR_B_3: J1.60 (PA3), U3.2 (IO5)
ADDR_B_4: J1.30 (PA4), U3.8 (IO10)
ADDR_B_5: J1.61 (PA5), U3.3 (IO6)
ADDR_B_6: J1.3 (PA6), U3.30 (IO22)
ADDR_B_7: J1.34 (PA7), U3.31 (IO21)
CIC_CLK: J1.56 (CIC_P6), SJ11.1
CIC_CLK_EXT: CIC_CLK_EXT.1, SJ11.2, U1.2 (A5)
CIC_D0: J1.24 (CIC_P1), U1.9 (C1)
CIC_D1: J1.55 (CIC_P2), U1.10 (C0)
CIC_RST: J1.25 (CIC_P7), U1.8 (C2)
COLOR_SC_OPT_O_PRE: SJ63B.1, U3.19 (IO31)
COLOR_SC_O_PRE: SJ63A.2, U3.21 (IO29)
COLOR_SC_PCB_O: COLOR_SC_O.1, R62.2, SJ62.2
COLOR_SC_PCB_O_PRE: R62.1, SJ62.1, U6.4 (Y)
COLOR_SC_PRE: R63.2, SJ63A.1, SJ63B.2, U6.3 (A)
CSYNC_I: CSYNC_I.1, CSYNC_I1.1, U3.33 (IO19)
CSYNC_O: CSYNC_O_BUF.1, R94.2
CSYNC_O_3V3_0: CSYNC_O_3V3_0.1, U3.13 (IO14)
CSYNC_O_3V3_1: CSYNC_O_3V3_1.1, R91.1, U3.34 (IO18)
CTRL2: CTRL_2.1, U2.11 (A2)
CTRL3: CTRL_3.1, U2.12 (A1)
CTRL4: CTRL_4.1, U2.13 (A0)
DATA_D4: J1.50 (D4), U4.3 (O), U4.6 (O)
DEJITTER_BYPASS: R31.2, SJ31.2, U3.44 (IO3)
GND: C1.2, C11.2, C21.2, C31.2, C32.2, C33.2, C34.2, C41.2, C51.2, C52.2, C61.2, C71.2, C72.2, C81.2, C82.2, C91.2, C92.2, GND.1, GND32.1, I2C.GND.1, J1.5 (GND), J1.36 (GND), JTAG.GND.1, R11.2, R21.1, R37.1, R52.2, R63.1, R92.2, R93.2, SJ32.2, U1.4 (A3), U1.14 (GND), U2.14 (GND), U3.4 (GND), U3.16 (GND), U3.24 (GND), U3.36 (GND), U3.38 (OE1), U3.39 (GCLR/), U3.40 (OE2-GCLK2), U4.4 (GND), U5.5 (GND), U5.10 (GND), U6.2 (GND), U7.2 (GND), U8.2 (GND), U9.P$2 (GND)
LED_G: LED_G.1, R23.2
LED_R: LED_R.1, R22.2
LED_TYPE: R21.2, SJ21.2, U1.7 (C3), U2.8 (C2)
MCLK_BASE_I: R53.2, U3.37 (GCLK1)
MCLK_BASE_I_PRE: R53.1, U5.11 (Y1)
MCLK_EXT_O: MCLK_EXT_O.1, R61.2, SJ61.1
MCLK_EXT_O_PRE: R61.1, U6.6 (Y)
MCLK_EXT_PRE: U3.22 (IO28), U6.1 (A)
MCLK_PAL_EXT_I: R54.2, U3.27 (IO24)
MCLK_PAL_EXT_I_PRE: R54.1, U5.8 (Y3)
MCLK_SNES: J1.1 (MCLK), SJ61.2
unnamed: R91.2, R92.1, SJ93.1, U9.P$1 (IN)
unnamed: U5.1 (XIN), X1.2
unnamed: U5.14 (XOUT), X1.1
unnamed: C94.1, U9.P$3 (SAG)
unnamed: C93.1, U9.P$4 (OUT)
unnamed: C93.2, C94.2, R94.1
unnamed: R93.1, SJ93.2
NPALMODE_0: #PALMODE_0.1, U3.12 (IO13)
NPALMODE_1: #PALMODE_1.1, U3.35 (IO17)
NPARD: J1.4 (/PARD), U3.28 (IO23)
PALMODE: PALMODE.1, R31.1, R51.2, U2.3 (A4), U3.6 (IO8)
PALMODE.1V8: R51.1, R52.1, U5.2 (S0)
REGION: U1.3 (A4), U2.4 (A3), U4.2 (I), U4.5 (I)
REGIONPATCH_EN: U2.7 (C3), U3.5 (IO7)
RST_I: R11.1, RST_I.1, U1.13 (A0), U2.2 (A5)
RST_O: RST_O_0.1, RST_O_1.1, U1.11 (A2)
SCIC_LED_G: U1.5 (C5), U2.10 (C0)
SCIC_LED_R: U1.6 (C4), U2.9 (C1)
SCL: I2C.SCL.1, U5.12 (S2/SCL)
SDA: I2C.SDA.1, U5.13 (S1/SDA)
SEL_SNES_1CHIP: R32.2, SJ32.1, U3.20 (IO30)
TCK: JTAG.TCK.1, R37.2, U3.26 (IO20/TCK)
TDI: JTAG.TDI.1, R38.2, U3.1 (IO4/TDI)
TDO: JTAG.TDO.1, U3.32 (IO25/TDO)
TMS: JTAG.TMS.1, R39.2, U3.7 (IO9/TMS)
UIGR_LED_G: R23.1, U2.5 (C5)
UIGR_LED_R: R22.1, U2.6 (C4)
VDDOUT: C51.1, FB51.1, U5.6 (VDDOUT), U5.7 (VDDOUT)

Notes on the sheet:
/PAL-Mode: to S-RGB P9
DFO (CDCE913) must output: - Y1: - NTSC 21.47727MHz at low S0 - PAL 17.734475MHz at high S0 - Y2: PAL 4.43361875MHz at high S0 - Y3: PAL 21.28137MHz at high S0
place SJ61 close to cart-slot p1
close SJ31 to always bypass de-jitter
close SJ21 for LED with CA
Info: - Schematic and PCB design (c) 2019 -2020 by Peter Bartmann - Design uses De-Jitter design (c) 2017-2018 by Markus Hiienkari - Design uses DFO 5V design by micro (2015)
S0 input to switch between frequencies S0 may not exceed 1.8V -> voltage divider
I2C in following order: GND,VCC,SDA,SDC to match programmer adapter by micro
U1 (SuperCIC-lock)
U2 (uIGR)
DFO 5V design
- De-Jitter design with integrated SNES Region Patch
SNES Slot + SuperCIC + uIGR
Power Supply
U7, U8: DDC-Packages
U4: TSSOP8
SJ32: - open = 1Chip - closed = 3Chip
R62 can be taken from SNES mainboard on 3Chip consoles as one resistor has to be removed anyway

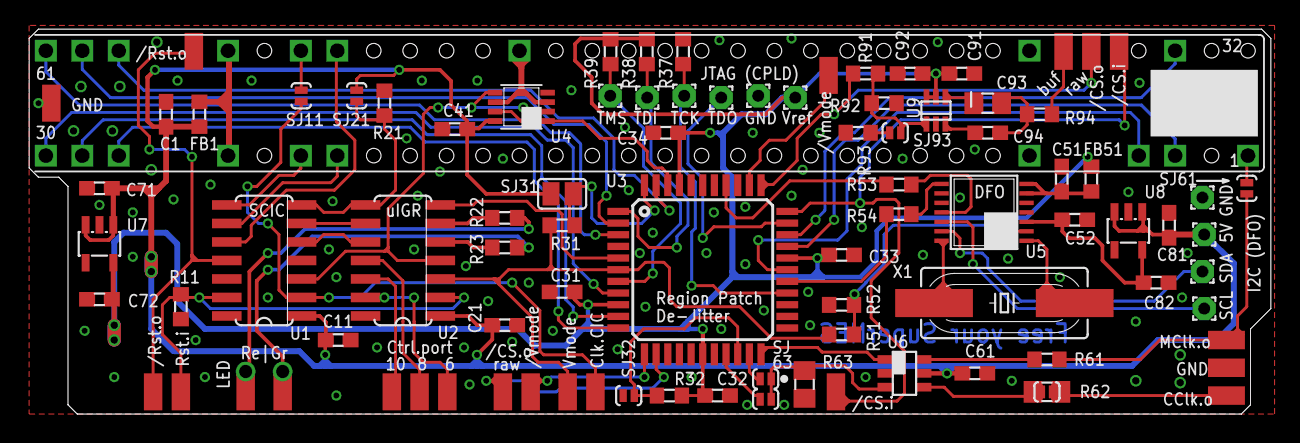
[picture p66: board SNES_MR_DeJitter_QID.brd from above]

Board: 2 copper layers, 85.2 x 26.4 mm, 92 parts (0 on the bottom side), 72 nets.
