phreakwiz/SNES-AddOn-PCBs/Classic_Multiregion_Mod_QID/SNES-3Chip/SNES-3Chip_MR_QID.brd

## EAGLE design Classic_Multiregion_Mod_QID/SNES-3Chip/SNES-3Chip_MR_QID.brd (2016-04-22)

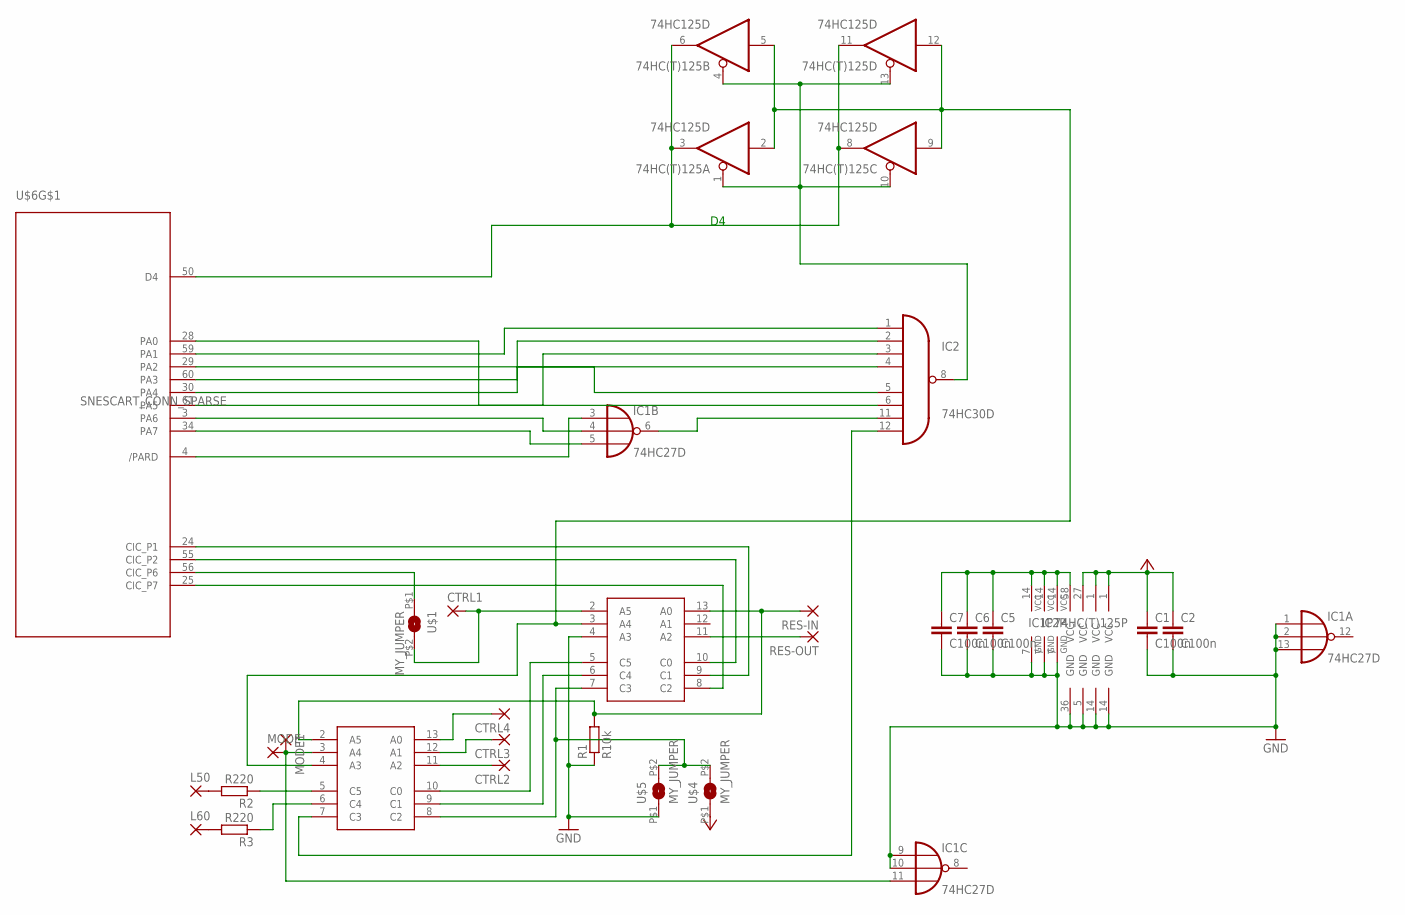
[picture p67: schematic SNES-3Chip_MR_QID.sch]

Parts:
74HC(T)125: 74HC125D; SO14
C1, C2, C5, C6, C7: C100n; Z0805
CTRL1, CTRL2, CTRL3, CTRL4: SMD2; SMD1,27-2,54
IC1: 74HC27D; SO14
IC2: 74HC30D; SO14
L50, L60: SMD2; SMD1,27-2,54
MODE, MODE1: SMD2; SMD1,27-2,54
R1: R10k; Z0805
R2, R3: R220; Z0805
RES-IN: SMD2; SMD1,27-2,54
RES-OUT: SMD2; SMD1,27-2,54
U$1, U$4, U$5: MY_JUMPER; MYJUMP
U$2, U$3: PIC16F630_SIMPLE; PIC16F630
U$6: SNESCART_CONN_SPARSE

Connections:
GND: 74HC(T)125.7 (GND), C1.2, C2.2, C5.2, C6.2, C7.2, IC1.1 (I0), IC1.2 (I1), IC1.7 (GND), IC1.9 (I0), IC1.10 (I1), IC1.13 (I2), IC2.7 (GND), R1.1, U$2.4 (A3), U$2.14 (GND), U$3.14 (GND), U$5.P$1 (1), U$6.5 (GND), U$6.36 (GND)
unnamed: 74HC(T)125.1 (OE), 74HC(T)125.4 (OE), 74HC(T)125.10 (OE), 74HC(T)125.13 (OE), IC2.8 (O)
unnamed: RES-OUT.1, U$2.11 (A2)
unnamed: IC2.3 (I2), U$6.61 (PA5)
unnamed: IC2.2 (I1), U$6.60 (PA3)
unnamed: IC1.3 (I0), U$6.4 (/PARD)
unnamed: IC1.4 (I1), U$6.3 (PA6)
unnamed: IC1.6 (O), IC2.11 (I6)
unnamed: IC2.6 (I5), U$6.28 (PA0)
unnamed: R1.2, RES-IN.1, U$2.13 (A0), U$3.2 (A5)
unnamed: L50.1, R2.2
unnamed: R2.1, U$3.5 (C5)
unnamed: R3.1, U$3.6 (C4)
unnamed: IC1.11 (I2), MODE.1, MODE1.1, U$3.3 (A4)
unnamed: L60.1, R3.2
unnamed: IC1.5 (I2), U$6.34 (PA7)
unnamed: IC2.12 (I7), U$3.7 (C3)
unnamed: U$1.P$1 (1), U$6.56 (CIC_P6)
unnamed: U$2.5 (C5), U$3.10 (C0)
unnamed: IC2.1 (I0), U$6.59 (PA1)
unnamed: IC2.5 (I4), U$6.29 (PA2)
unnamed: IC2.4 (I3), U$6.30 (PA4)
unnamed: CTRL2.1, U$3.11 (A2)
unnamed: CTRL3.1, U$3.12 (A1)
unnamed: CTRL1.1, U$1.P$2 (2), U$2.2 (A5)
unnamed: 74HC(T)125.3 (O), 74HC(T)125.6 (O), 74HC(T)125.8 (O), 74HC(T)125.11 (O), U$6.50 (D4)
unnamed: CTRL4.1, U$3.13 (A0)
unnamed: U$2.10 (C0), U$6.55 (CIC_P2)
unnamed: U$2.9 (C1), U$6.24 (CIC_P1)
unnamed: U$2.8 (C2), U$6.25 (CIC_P7)
unnamed: U$2.6 (C4), U$3.9 (C1)
unnamed: U$2.7 (C3), U$3.8 (C2), U$4.P$2 (2), U$5.P$2 (2)
UIGR: 74HC(T)125.2 (I), 74HC(T)125.5 (I), 74HC(T)125.9 (I), 74HC(T)125.12 (I), U$2.3 (A4), U$3.4 (A3)
VCC: C1.1, C2.1, U$2.1 (VCC), U$3.1 (VCC), U$4.P$1 (1), U$6.27 (VCC)
VCC_2: 74HC(T)125.14 (VCC), C5.1, C6.1, C7.1, IC1.14 (VCC), IC2.14 (VCC), U$6.58 (VCC)

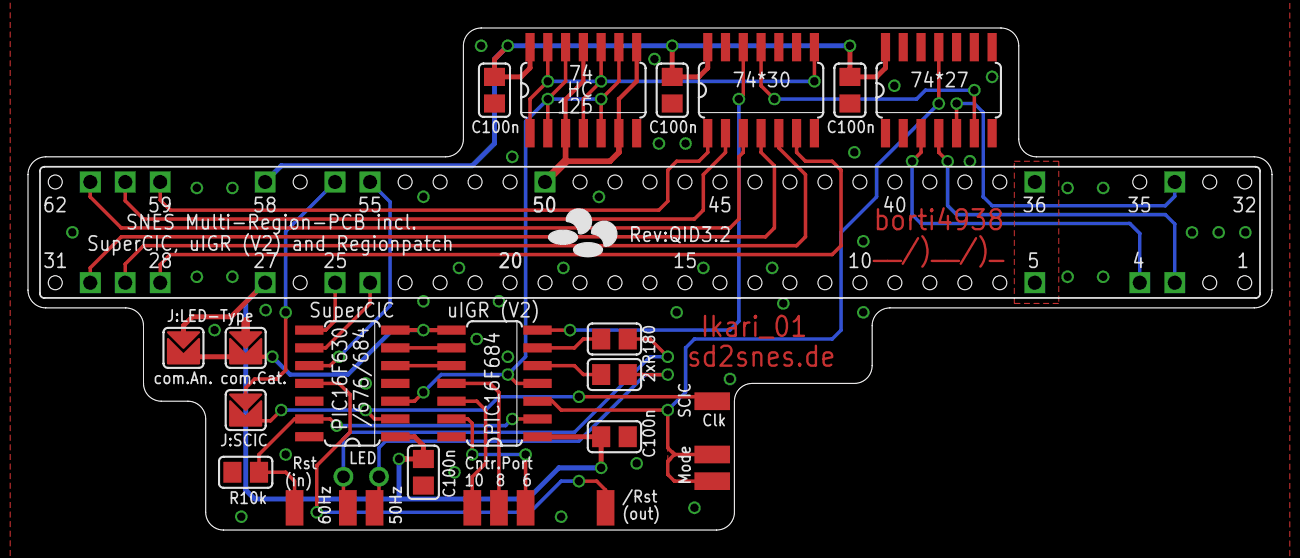
[picture p68: board SNES-3Chip_MR_QID.brd from above]

Board: 2 copper layers, 88.9 x 35.9 mm, 27 parts (0 on the bottom side), 35 nets.
