phreakwiz/SNES-AddOn-PCBs/digAudio/digAudio-rcj-tg10da1nslf.brd

## EAGLE design digAudio/digAudio-rcj-tg10da1nslf.brd (2018-02-14)

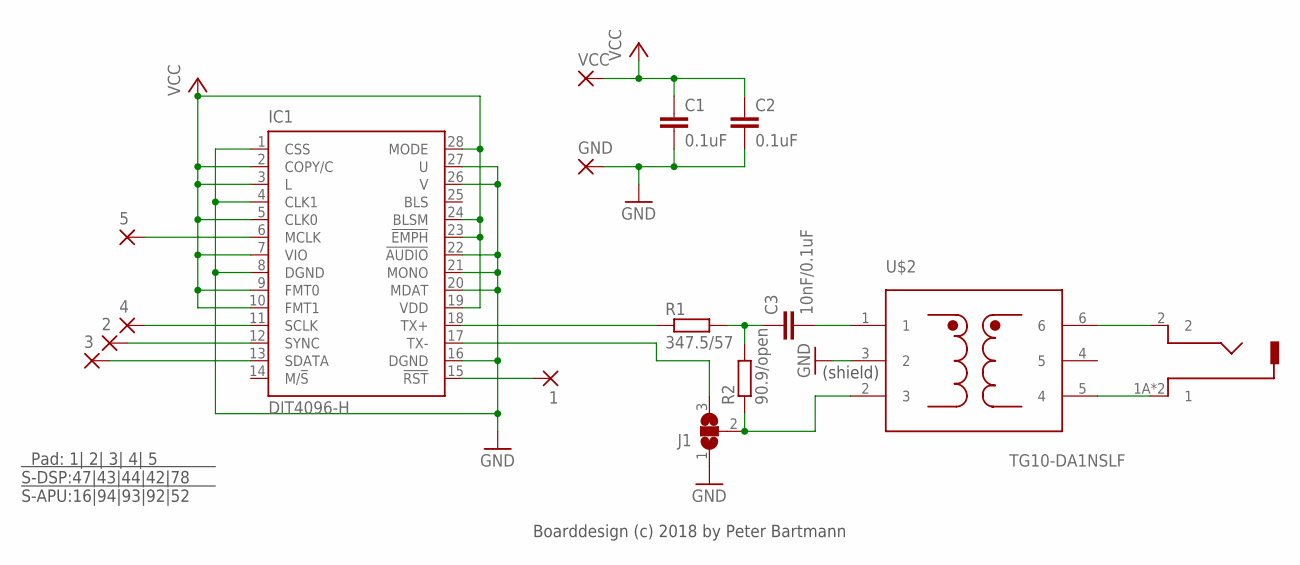
[picture p69: schematic digAudio-rcj-tg10da1nslf.sch]

Parts:
1, 2, 3, 4, 5: SMD1; SMD0,8-1,6
C1, C2: 0.1uF; C0603
C3: 10nF/0.1uF; C0603
GND: 1,6/0,9
IC1: DIT4096-H; PW_R-PDSO-G28
J1: SJ2W; SJ_2
R1: 347.5/57; R0603
R2: 90.9/open; R0603
U$1: RCJ-013-SMT-TR; RCJ_01X_SMT_MODIFIED
U$2: TG10-DA1NSLF; TG10-DA1NSFL
VCC: 1,6/0,9

Connections:
GND: C1.2, C2.2, GND.1, IC1.1 (CSS), IC1.4 (CLK1), IC1.8 (DGND), IC1.16 (DGND), IC1.20 (MDAT), IC1.21 (MONO), IC1.22 (!AUDIO), IC1.26 (V), IC1.27 (U), J1.1, U$2.3 (2)
unnamed: IC1.18 (TX+), R1.1
unnamed: 1.P$1, IC1.15 (!RST)
unnamed: 2.P$1, IC1.12 (SYNC)
unnamed: 4.P$1, IC1.11 (SCLK)
unnamed: 3.P$1, IC1.13 (SDATA)
unnamed: 5.P$1, IC1.6 (MCLK)
unnamed: IC1.17 (TX-), J1.3
unnamed: C3.1, R1.2, R2.2
unnamed: U$1.2, U$2.6
unnamed: U$1.1A (1), U$1.1B (1), U$2.5 (4)
unnamed: C3.2, U$2.1
unnamed: J1.2, R2.1, U$2.2 (3)
VCC: C1.1, C2.1, IC1.2 (COPY/C), IC1.3 (L), IC1.5 (CLK0), IC1.7 (VIO), IC1.9 (FMT0), IC1.10 (FMT1), IC1.19 (VDD), IC1.23 (!EMPH), IC1.24 (BLSM), IC1.28 (MODE), VCC.1

Notes on the sheet:
Pad: 1| 2| 3| 4| 5 S-DSP:47|43|44|42|78 S-APU:16|94|93|92|52
Boarddesign (c) 2018 by Peter Bartmann
(shield)

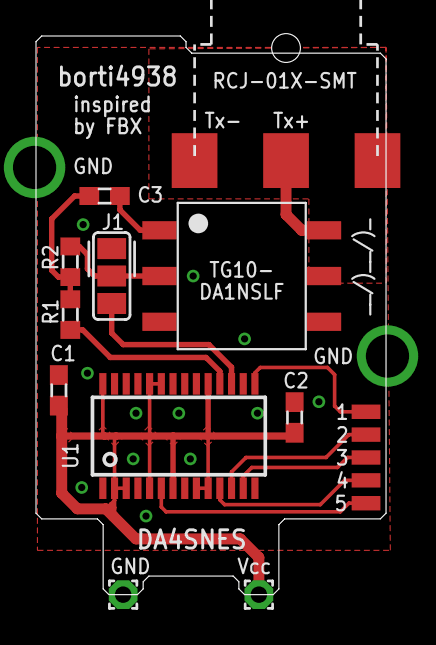
[picture p70: board digAudio-rcj-tg10da1nslf.brd from above]

Board: 2 copper layers, 19.4 x 31.0 mm, 16 parts (0 on the bottom side), 14 nets.
