phreakwiz/SNES-AddOn-PCBs/Classic_MR_Boards/Switchless-Addon-1chip/SNES_AddOn1Chip.brd

## EAGLE design Classic_MR_Boards/Switchless-Addon-1chip/SNES_AddOn1Chip.brd (2017-11-23)

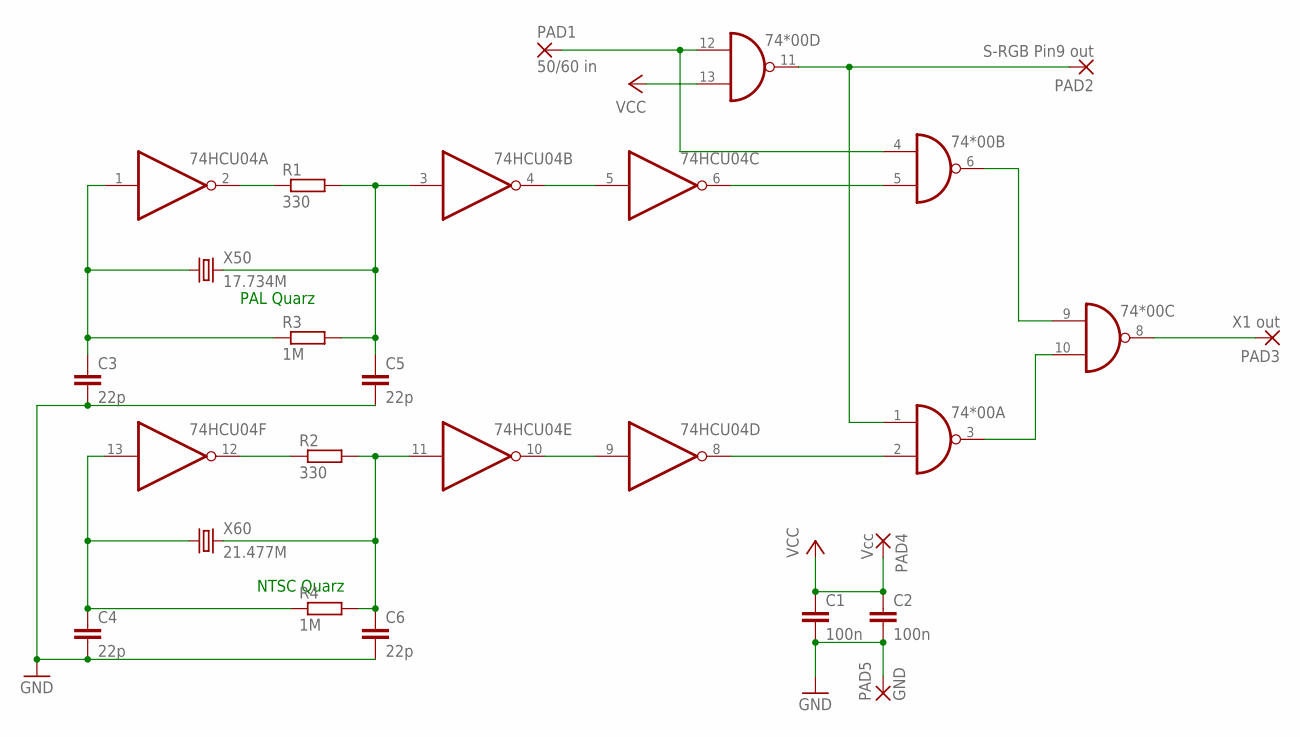
[picture p71: schematic SNES_AddOn1Chip.sch]

Parts:
74*00: 7400D; SO14
74HCU04: 74HC04D; SO14
C1, C2: 100n; Z0805
C3, C4, C5, C6: 22p; Z0805
PAD1: 50/60 in; SMD1,27-2,54
PAD2: S-RGB Pin9 out; SMD1,27-2,54
PAD3: X1 out; SMD1,27-2,54
PAD4: Vcc; SMD2,54-5,08
PAD5: GND; SMD2,54-5,08
R1, R2: 330; Z0805
R3, R4: 1M; Z0805
X50: 17.734M; MY_SMD_CRYSTAL2
X60: 21.477M; MY_SMD_CRYSTAL2

Connections:
GND: 74*00.7 (GND), 74HCU04.7 (GND), C1.2, C2.2, C3.2, C4.2, C5.2, C6.2, PAD5.1
unnamed: 74HCU04.1 (I), C3.1, R3.1, X50.1
unnamed: 74HCU04.3 (I), C5.1, R1.2, R3.2, X50.2
unnamed: 74HCU04.13 (I), C4.1, R4.1, X60.1
unnamed: 74HCU04.11 (I), C6.1, R2.2, R4.2, X60.2
unnamed: 74*00.3 (O), 74*00.10 (I1)
unnamed: 74*00.6 (O), 74*00.9 (I0)
unnamed: 74*00.4 (I0), 74*00.12 (I0), PAD1.1
unnamed: 74*00.1 (I0), 74*00.11 (O), PAD2.1
unnamed: 74*00.8 (O), PAD3.1
unnamed: 74HCU04.2 (O), R1.1
unnamed: 74HCU04.4 (O), 74HCU04.5 (I)
unnamed: 74*00.5 (I1), 74HCU04.6 (O)
unnamed: 74*00.2 (I1), 74HCU04.8 (O)
unnamed: 74HCU04.9 (I), 74HCU04.10 (O)
unnamed: 74HCU04.12 (O), R2.1
VCC: 74*00.13 (I1), 74*00.14 (VCC), 74HCU04.14 (VCC), C1.1, C2.1, PAD4.1

Notes on the sheet:
PAL Quarz
NTSC Quarz

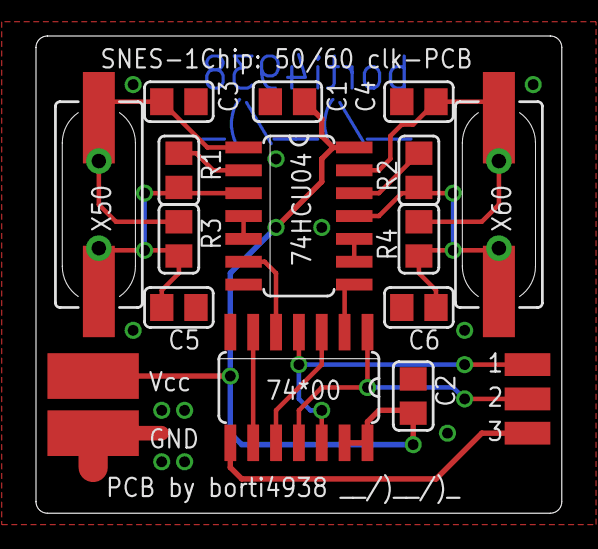
[picture p72: board SNES_AddOn1Chip.brd from above]

Board: 2 copper layers, 29.2 x 26.5 mm, 19 parts (0 on the bottom side), 17 nets.
