phreakwiz/SNES-AddOn-PCBs/Classic_MR_Boards/Switchless-Basic/SNES_Basic.brd

## EAGLE design Classic_MR_Boards/Switchless-Basic/SNES_Basic.brd (2017-11-23)

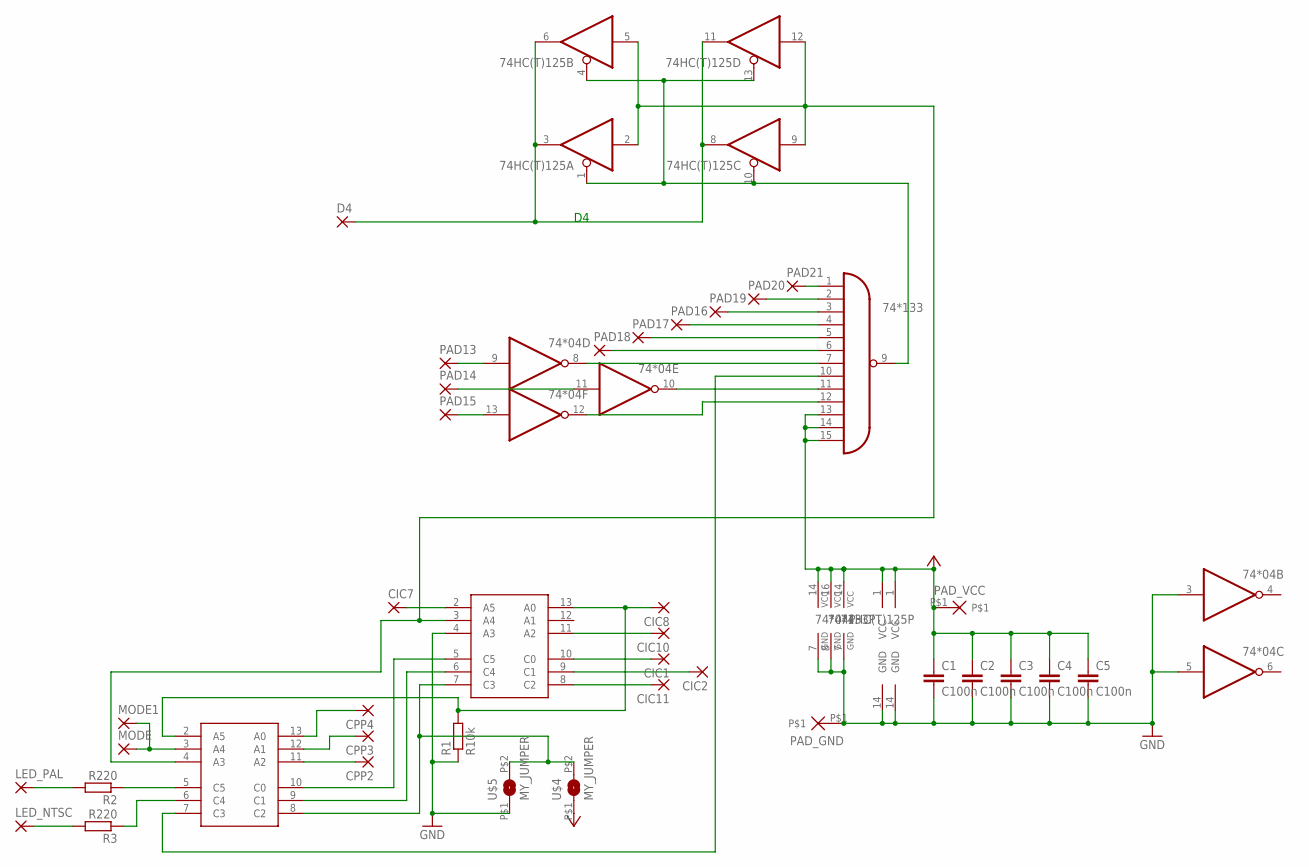
[picture p73: schematic SNES_Basic.sch]

Parts:
74*04: 74S04D; SO14
74*133: 74S133D; SO16
74HC(T)125: 74HCT125D; SO14
C1, C2, C3, C4, C5: C100n; Z0805
CIC1, CIC2, CIC7, CIC8, CIC10, CIC11: SMD2; SMD1,27-2,54
CPP2, CPP3, CPP4: SMD2; SMD1,27-2,54
D4: SMD2; SMD1,27-2,54
LED_NTSC: SMD2; SMD1,27-2,54
LED_PAL: SMD2; SMD1,27-2,54
MODE, MODE1: SMD2; SMD1,27-2,54
PAD13, PAD14, PAD15, PAD16, PAD17, PAD18, PAD19, PAD20, PAD21: SMD2; SMD1,27-2,54
PAD_GND: PAD; PADS
PAD_VCC: PAD; PADS
R1: R10k; Z0805
R2, R3: R220; Z0805
U$2, U$3: PIC16F630_SIMPLE; PIC16F630
U$4, U$5: MY_JUMPER; MYJUMP

Connections:
D4_ON/OFF: 74*133.10 (I7), U$3.7 (C3)
GND: 74*04.3 (I), 74*04.5 (I), 74*04.7 (GND), 74*133.8 (GND), 74HC(T)125.7 (GND), C1.2, C2.2, C3.2, C4.2, C5.2, PAD_GND.P$1, R1.1, U$2.4 (A3), U$2.14 (GND), U$3.14 (GND), U$5.P$1 (1)
unnamed: LED_PAL.1, R2.2
unnamed: 74*133.9 (O), 74HC(T)125.1 (OE), 74HC(T)125.4 (OE), 74HC(T)125.10 (OE), 74HC(T)125.13 (OE)
unnamed: CIC10.1, U$2.11 (A2)
unnamed: 74*133.5 (I4), PAD17.1
unnamed: 74*133.4 (I3), PAD16.1
unnamed: 74*133.3 (I2), PAD19.1
unnamed: 74*133.2 (I1), PAD20.1
unnamed: 74*133.1 (I0), PAD21.1
unnamed: CIC7.1, U$2.2 (A5)
unnamed: CIC8.1, R1.2, U$2.13 (A0), U$3.2 (A5)
unnamed: 74*04.9 (I), PAD13.1
unnamed: R2.1, U$3.5 (C5)
unnamed: R3.1, U$3.6 (C4)
unnamed: LED_NTSC.1, R3.2
unnamed: 74*133.6 (I5), PAD18.1
unnamed: 74*04.8 (O), 74*133.7 (I6)
unnamed: 74*04.10 (O), 74*133.11 (I8)
unnamed: 74*04.13 (I), PAD15.1
unnamed: U$2.5 (C5), U$3.10 (C0)
unnamed: 74*04.12 (O), 74*133.12 (I9)
unnamed: 74*04.11 (I), PAD14.1
unnamed: CPP2.1, U$3.11 (A2)
unnamed: CPP3.1, U$3.12 (A1)
unnamed: 74HC(T)125.3 (O), 74HC(T)125.6 (O), 74HC(T)125.8 (O), 74HC(T)125.11 (O), D4.1
unnamed: CPP4.1, U$3.13 (A0)
unnamed: CIC1.1, U$2.10 (C0)
unnamed: CIC2.1, U$2.9 (C1)
unnamed: CIC11.1, U$2.8 (C2)
unnamed: U$2.6 (C4), U$3.9 (C1)
unnamed: U$2.7 (C3), U$3.8 (C2), U$4.P$2 (2), U$5.P$2 (2)
unnamed: MODE.1, MODE1.1, U$3.3 (A4)
UIGR: 74HC(T)125.2 (I), 74HC(T)125.5 (I), 74HC(T)125.9 (I), 74HC(T)125.12 (I), U$2.3 (A4), U$3.4 (A3)
VCC: 74*04.14 (VCC), 74*133.13 (I10), 74*133.14 (I11), 74*133.15 (I12), 74*133.16 (VCC), 74HC(T)125.14 (VCC), C1.1, C2.1, C3.1, C4.1, C5.1, PAD_VCC.P$1, U$2.1 (VCC), U$3.1 (VCC), U$4.P$1 (1)

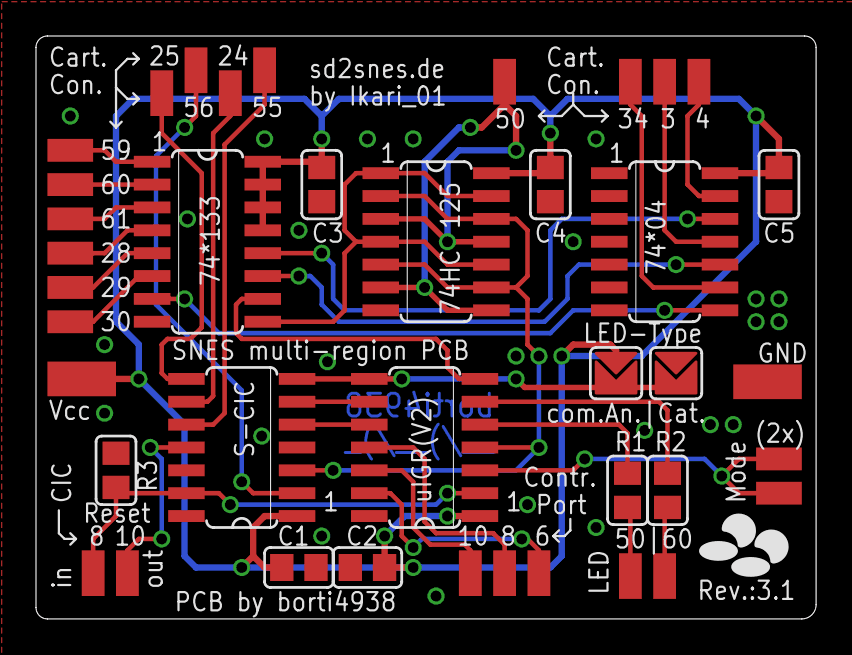
[picture p74: board SNES_Basic.brd from above]

Board: 2 copper layers, 43.3 x 32.4 mm, 40 parts (0 on the bottom side), 35 nets.
