phreakwiz/SNES-AddOn-PCBs/Classic_MR_Boards/Switchless-1Chip-all/SNES1Chip_SCIC_IGR_D4_Takt.brd

## EAGLE design Classic_MR_Boards/Switchless-1Chip-all/SNES1Chip_SCIC_IGR_D4_Takt.brd (2017-11-23)

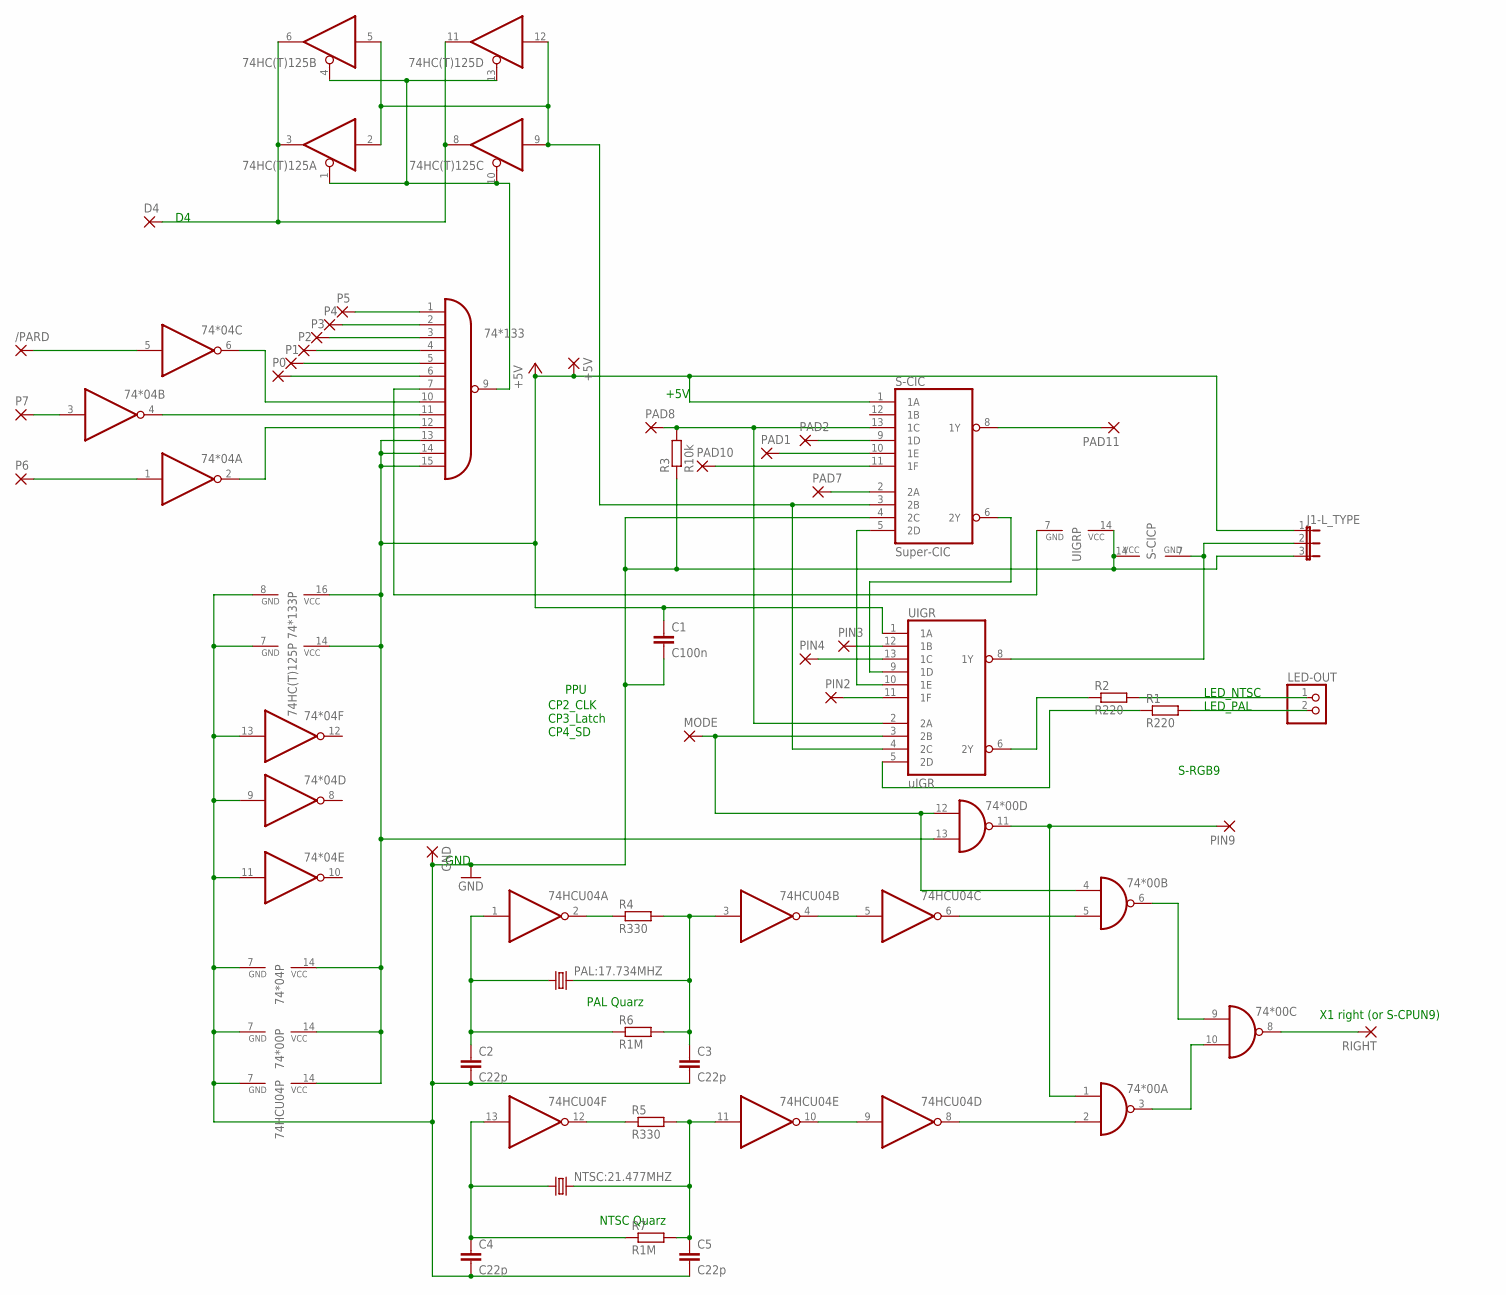
[picture p75: schematic SNES1Chip_SCIC_IGR_D4_Takt.sch]

Parts:
74*00: 7400D; SO14
74*04: 74S04D; SO14
74*133: 74S133D; SO16
74HC(T)125: 74HCT125D; SO14
74HCU04: 74HC04D; SO14
+5V: 2,54/0,8
/PARD: 2,54/0,8
C1: C100n; C0805
C2, C3, C4, C5: C22p; C0805
D4: 2,54/0,8
GND: 2,54/0,8
J1-L_TYPE: JP2E; JP2
LED-OUT: PINHD-1X2; 1X02
MODE: 2,54/0,8
NTSC:21.477MHZ: CRYSTALHC49S; HC49/S
P0, P1, P2, P3, P4, P5, P6, P7: 2,54/0,8
PAD1, PAD2, PAD7, PAD8, PAD10, PAD11: 2,54/0,8
PAL:17.734MHZ: CRYSTALHC49S; HC49/S
PIN2, PIN3, PIN4, PIN9: 2,54/0,8
R1, R2: R220; R0805
R3: R10k; R0805
R4, R5: R330; R0805
R6, R7: R1M; R0805
RIGHT: 2,54/0,8
S-CIC: Super-CIC; SO14
UIGR: uIGR; SO14

Connections:
+5V: 74*00.13 (I1), 74*00.14 (VCC), 74*04.14 (VCC), 74*133.13 (I10), 74*133.14 (I11), 74*133.15 (I12), 74*133.16 (VCC), 74HC(T)125.14 (VCC), 74HCU04.14 (VCC), +5V.1, C1.1, J1-L_TYPE.1, S-CIC.1 (1A), UIGR.1 (1A)
GND: 74*00.7 (GND), 74*04.7 (GND), 74*04.9 (I), 74*04.11 (I), 74*04.13 (I), 74*133.8 (GND), 74HC(T)125.7 (GND), 74HCU04.7 (GND), C1.2, C2.2, C3.2, C4.2, C5.2, GND.1, J1-L_TYPE.3, R3.1, S-CIC.4 (2C), S-CIC.14 (VCC), UIGR.14 (VCC)
unnamed: 74*04.4 (O), 74*133.11 (I8)
unnamed: 74*133.9 (O), 74HC(T)125.1 (OE), 74HC(T)125.4 (OE), 74HC(T)125.10 (OE), 74HC(T)125.13 (OE)
unnamed: PAD10.1, S-CIC.11 (1F)
unnamed: PAD11.1, S-CIC.8 (1Y)
unnamed: LED-OUT.1, R2.2
unnamed: 74*04.1 (I), P6.1
unnamed: R2.1, UIGR.6 (2Y)
unnamed: J1-L_TYPE.2, S-CIC.7 (GND), UIGR.8 (1Y)
unnamed: 74*04.6 (O), 74*133.10 (I7)
unnamed: PAD7.1, S-CIC.2 (2A)
unnamed: R1.1, UIGR.5 (2D)
unnamed: PAD2.1, S-CIC.9 (1D)
unnamed: PAD1.1, S-CIC.10 (1E)
unnamed: LED-OUT.2, R1.2
unnamed: 74*133.6 (I5), P0.1
unnamed: 74*04.3 (I), P7.1
unnamed: PIN2.1, UIGR.11 (1F)
unnamed: PIN3.1, UIGR.12 (1B)
unnamed: PIN4.1, UIGR.13 (1C)
unnamed: 74*04.2 (O), 74*133.12 (I9)
unnamed: 74*133.1 (I0), P5.1
unnamed: 74*133.2 (I1), P4.1
unnamed: S-CIC.6 (2Y), UIGR.9 (1D)
unnamed: 74*133.3 (I2), P3.1
unnamed: 74*133.4 (I3), P2.1
unnamed: 74*04.5 (I), /PARD.1
unnamed: 74HCU04.1 (I), C2.1, PAL:17.734MHZ.1, R6.1
unnamed: 74HCU04.3 (I), C3.1, PAL:17.734MHZ.2, R4.2, R6.2
unnamed: 74HCU04.13 (I), C4.1, NTSC:21.477MHZ.1, R7.1
unnamed: 74HCU04.11 (I), C5.1, NTSC:21.477MHZ.2, R5.2, R7.2
unnamed: 74*00.3 (O), 74*00.10 (I1)
unnamed: 74*00.6 (O), 74*00.9 (I0)
unnamed: 74*00.4 (I0), 74*00.12 (I0), MODE.1, UIGR.3 (2B)
unnamed: PAD8.1, R3.2, S-CIC.13 (1C), UIGR.2 (2A)
unnamed: 74*00.1 (I0), 74*00.11 (O), PIN9.1
unnamed: 74*00.8 (O), RIGHT.1
unnamed: 74HCU04.2 (O), R4.1
unnamed: 74HCU04.4 (O), 74HCU04.5 (I)
unnamed: 74*00.5 (I1), 74HCU04.6 (O)
unnamed: 74*133.5 (I4), P1.1
unnamed: 74*00.2 (I1), 74HCU04.8 (O)
unnamed: 74HC(T)125.3 (O), 74HC(T)125.6 (O), 74HC(T)125.8 (O), 74HC(T)125.11 (O), D4.1
unnamed: 74*133.7 (I6), UIGR.7 (GND)
unnamed: 74HCU04.9 (I), 74HCU04.10 (O)
unnamed: 74HCU04.12 (O), R5.1
unnamed: S-CIC.5 (2D), UIGR.10 (1E)
UIGR: 74HC(T)125.2 (I), 74HC(T)125.5 (I), 74HC(T)125.9 (I), 74HC(T)125.12 (I), S-CIC.3 (2B), UIGR.4 (2C)

Notes on the sheet:
PPU
+5V
GND
CP2_CLK CP3_Latch CP4_SD
PAL Quarz
NTSC Quarz
S-RGB9
X1 right (or S-CPUN9)
LED_NTSC LED_PAL

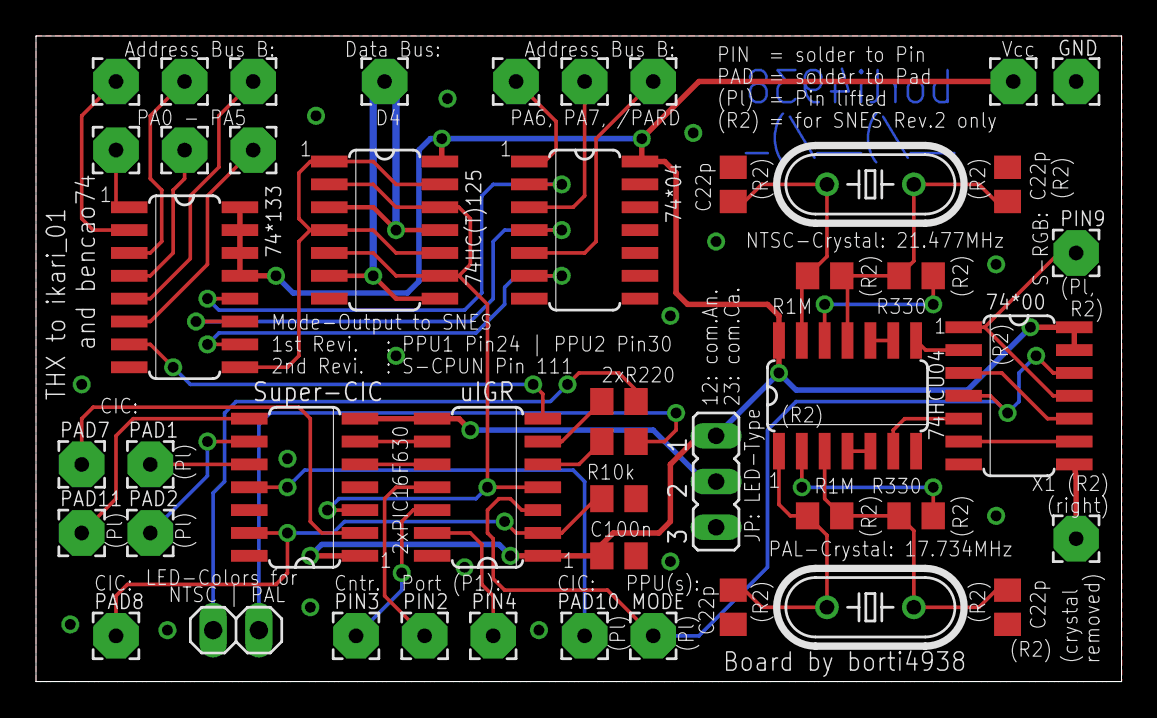
[picture p76: board SNES1Chip_SCIC_IGR_D4_Takt.brd from above]

Board: 2 copper layers, 60.3 x 35.9 mm, 47 parts (0 on the bottom side), 49 nets.
