phreakwiz/SNES-AddOn-PCBs/RGB Bypass/SNES_RGBAmp_wCSYNC_SVid.brd

## EAGLE design RGB Bypass/SNES_RGBAmp_wCSYNC_SVid.brd (2017-02-14)

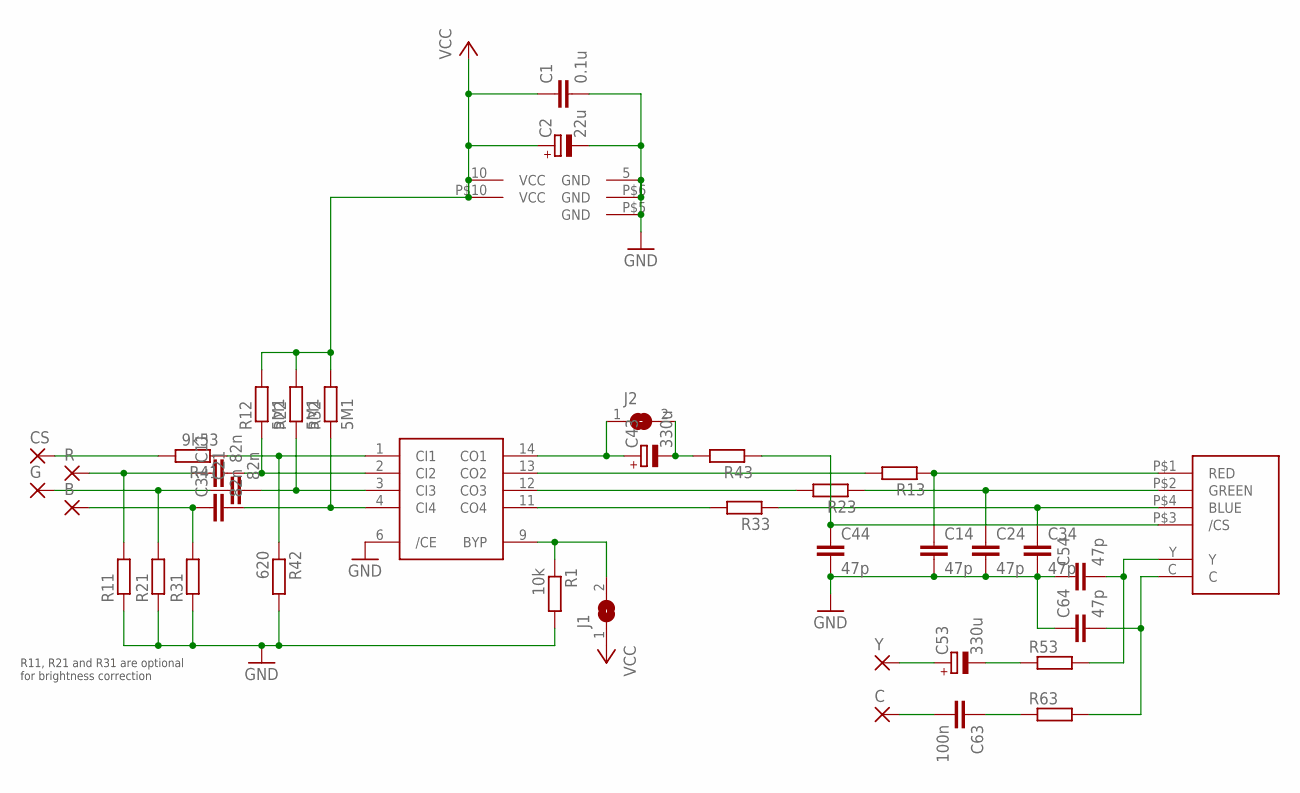
[picture p77: schematic SNES_RGBAmp_wCSYNC_SVid.sch]

Parts:
B: SMD2; SMD1,27-2,54
C: SMD2; SMD1,27-2,54
C1: 0.1u; C0603K
C2: 22u; SMC_B
C11, C21, C31: 82n; C0603K
C14, C24, C34, C44, C54, C64: 47p; C0603K
C43, C53: 330u; SMC_D
C63: 100n; C0603K
CS: SMD2; SMD1,27-2,54
G: SMD2; SMD1,27-2,54
J1, J2: SJ
R: SMD2; SMD1,27-2,54
R1: 10k; R0603
R11, R13, R21, R23, R31, R33, R43, R53, R63: R-EU_R0603; R0603
R12, R22, R32: 5M1; R0603
R41: 9k53; R0603
R42: 620; R0603
U1: THS7374
U$1: SNES_MULTIAV_RGBSYC
Y: SMD2; SMD1,27-2,54

Connections:
GND: C1.2, C2.-, C14.2, C24.2, C34.2, C44.2, C54.1, C64.1, R1.2, R11.1, R21.1, R31.1, R42.2, U1.5 (GND), U1.6 (/CE), U$1.P$5 (GND), U$1.P$6 (GND)
unnamed: C11.2, R12.1, U1.2 (CI2)
unnamed: C21.2, R22.1, U1.3 (CI3)
unnamed: J1.2, R1.1, U1.9 (BYP)
unnamed: C44.1, R43.1, U$1.P$3 (/CS)
unnamed: C14.1, R13.1, U$1.P$1 (RED)
unnamed: C24.1, R23.1, U$1.P$2 (GREEN)
unnamed: R23.2, U1.12 (CO3)
unnamed: R13.2, U1.13 (CO2)
unnamed: C34.1, R33.1, U$1.P$4 (BLUE)
unnamed: R41.1, R42.1, U1.1 (CI1)
unnamed: R33.2, U1.11 (CO4)
unnamed: C53.+, Y.1
unnamed: C.1, C63.2
unnamed: C11.1, R.1, R11.2
unnamed: C21.1, G.1, R21.2
unnamed: B.1, C31.1, R31.2
unnamed: CS.1, R41.2
unnamed: C43.+, J2.1, U1.14 (CO1)
unnamed: C43.-, J2.2, R43.2
unnamed: C53.-, R53.1
unnamed: C54.2, R53.2, U$1.Y
unnamed: C64.2, R63.2, U$1.C
unnamed: C63.1, R63.1
R9: C31.2, R32.1, U1.4 (CI4)
VCC: C1.1, C2.+, J1.1, R12.2, R22.2, R32.2, U1.10 (VCC), U$1.P$10 (VCC)

Notes on the sheet:
R11, R21 and R31 are optional for brightness correction

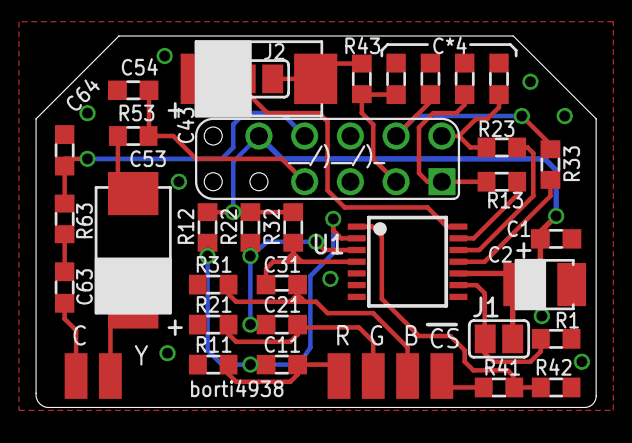
[picture p78: board SNES_RGBAmp_wCSYNC_SVid.brd from above]

Board: 2 copper layers, 31.1 x 20.6 mm, 39 parts (0 on the bottom side), 26 nets.
