phreakwiz/SNES-AddOn-PCBs/sd2snes_RevH/sd2snes_revH.brd

## EAGLE design sd2snes_RevH/sd2snes_revH.brd (2017-01-26)

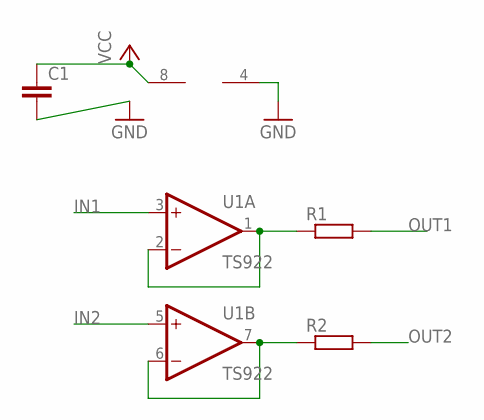
[picture p79: schematic sd2snes_revH.sch]

Parts:
C1: C-EUC0603; C0603
R1, R2: R-EU_R0603; R0603
U1: TS922; SO08

Connections:
GND: C1.2, U1.4 (V-)
IN1: U1.3 (+IN)
IN2: U1.5 (+IN)
unnamed: R1.1, U1.1 (OUT), U1.2 (-IN)
unnamed: R2.1, U1.6 (-IN), U1.7 (OUT)
OUT1: R1.2
OUT2: R2.2
VCC: C1.1, U1.8 (V+)

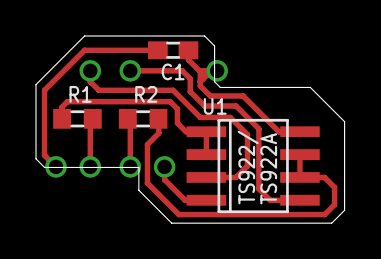
[picture p80: board sd2snes_revH.brd from above]

Board: 2 copper layers, 17.1 x 10.4 mm, 4 parts (0 on the bottom side), 4 nets.
