phreakwiz/SNES-AddOn-PCBs/digAudio/digAudio-PLT133.brd

## EAGLE design digAudio/digAudio-PLT133.brd (2016-04-22)

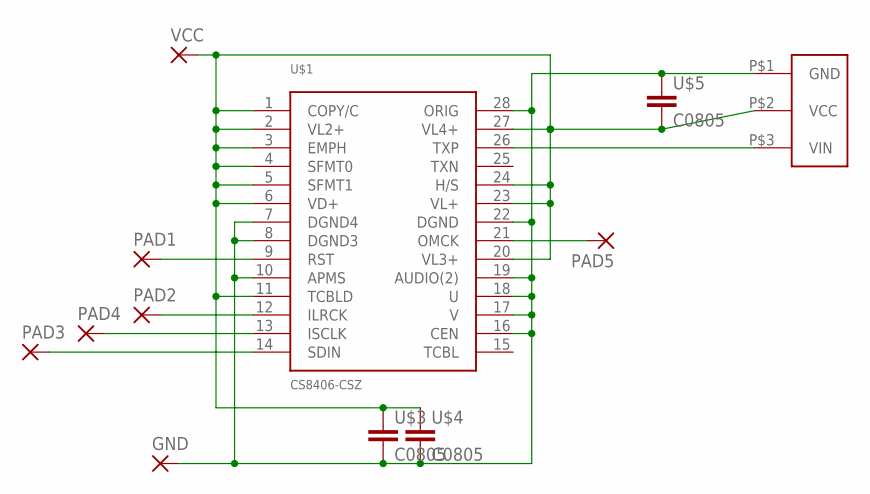
[picture p81: schematic digAudio-PLT133.sch]

Parts:
GND: SMD2; SMD1,27-2,54
PAD1, PAD2, PAD3, PAD4, PAD5: SMD2; SMD1,27-2,54
U$1: CS8406-CSZ; SO28W
U$3, U$4, U$5: C0805; Z0805
U$6: PLT133/T10W
VCC: SMD2; SMD1,27-2,54

Connections:
GND: GND.1, U$1.7 (DGND4), U$1.8 (DGND3), U$1.10 (APMS), U$1.16 (CEN), U$1.17 (V), U$1.18 (U), U$1.19 (AUDIO(2)), U$1.22 (DGND), U$1.28 (ORIG), U$3.2, U$4.2, U$5.1, U$6.P$1 (GND)
unnamed: U$1.26 (TXP), U$6.P$3 (VIN)
unnamed: PAD1.1, U$1.9 (RST)
unnamed: PAD2.1, U$1.12 (ILRCK)
unnamed: PAD4.1, U$1.13 (ISCLK)
unnamed: PAD3.1, U$1.14 (SDIN)
unnamed: PAD5.1, U$1.21 (OMCK)
VCC: U$1.1 (COPY/C), U$1.2 (VL2+), U$1.3 (EMPH), U$1.4 (SFMT0), U$1.5 (SFMT1), U$1.6 (VD+), U$1.11 (TCBLD), U$1.20 (VL3+), U$1.23 (VL+), U$1.24 (H/S), U$1.27 (VL4+), U$3.1, U$4.1, U$5.2, U$6.P$2 (VCC), VCC.1

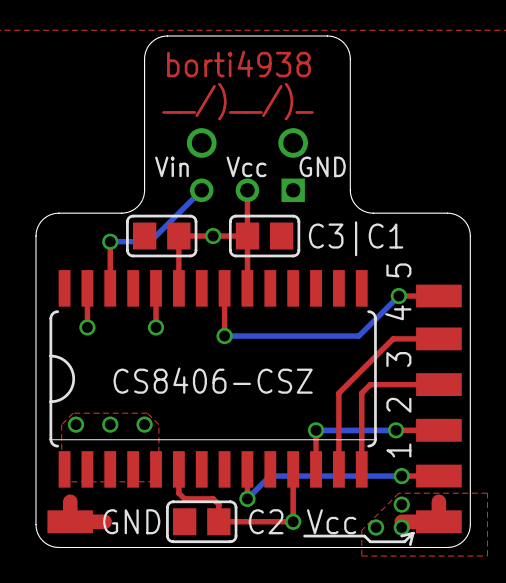
[picture p82: board digAudio-PLT133.brd from above]

Board: 2 copper layers, 24.1 x 28.4 mm, 12 parts (1 on the bottom side), 8 nets.
