phreakwiz/SNES-AddOn-PCBs/RGB Bypass/1Chip-SNES/SNES_RGBAmp_1Chip03+/SNES_RGBAmp_1Chip03+.brd

## EAGLE design RGB Bypass/1Chip-SNES/SNES_RGBAmp_1Chip03+/SNES_RGBAmp_1Chip03+.brd (2016-04-22)

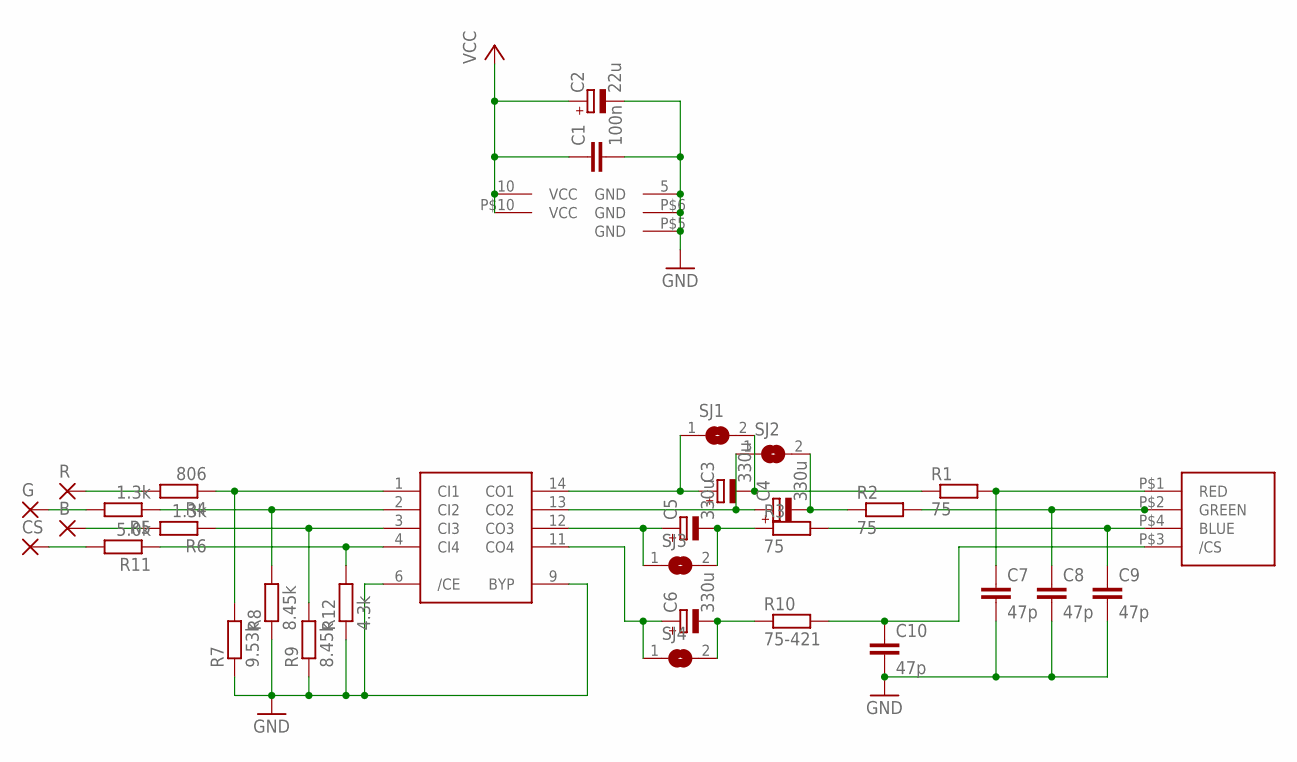
[picture p83: schematic SNES_RGBAmp_1Chip03+.sch]

Parts:
B: SMD2; SMD1,27-2,54
C1: 100n; Z0805
C2: 22u; SMC_C
C3, C4, C5, C6: 330u; SMC_D
C7, C8, C9, C10: 47p; Z0805
CS: SMD2; SMD1,27-2,54
G: SMD2; SMD1,27-2,54
R: SMD2; SMD1,27-2,54
R1, R2, R3: 75; Z0805
R4: 806; Z0805
R5, R6: 1.3k; Z0805
R7: 9.53k; Z0805
R8, R9: 8.45k; Z0805
R10: 75-421; Z0805
R11: 5.0k; Z0805
R12: 4.3k; Z0805
SJ1, SJ2, SJ3, SJ4: SJ
U$2: THS7374
U$3: SNES_MULTIAV_RGBC_ONLY

Connections:
GND: C1.2, C2.-, C7.2, C8.2, C9.2, C10.2, R7.1, R8.1, R9.1, R12.1, U$2.5 (GND), U$2.6 (/CE), U$2.9 (BYP), U$3.P$5 (GND), U$3.P$6 (GND)
unnamed: R4.1, R7.2, U$2.1 (CI1)
unnamed: R5.1, R8.2, U$2.2 (CI2)
unnamed: C3.-, R1.1, SJ1.2
unnamed: C7.1, R1.2, U$3.P$1 (RED)
unnamed: C8.1, R2.2, U$3.P$2 (GREEN)
unnamed: C4.+, SJ2.1, U$2.13 (CO2)
unnamed: C5.-, R3.1, SJ3.2
unnamed: C9.1, R3.2, U$3.P$4 (BLUE)
unnamed: R11.1, R12.2, U$2.4 (CI4)
unnamed: C5.+, SJ3.1, U$2.12 (CO3)
unnamed: C3.+, SJ1.1, U$2.14 (CO1)
unnamed: C4.-, R2.1, SJ2.2
unnamed: R.1, R4.2
unnamed: G.1, R5.2
unnamed: B.1, R6.2
unnamed: CS.1, R11.2
unnamed: C6.+, SJ4.1, U$2.11 (CO4)
unnamed: C6.-, R10.1, SJ4.2
unnamed: C10.1, R10.2, U$3.P$3 (/CS)
R9: R6.1, R9.2, U$2.3 (CI3)
VCC: C1.1, C2.+, U$2.10 (VCC), U$3.P$10 (VCC)

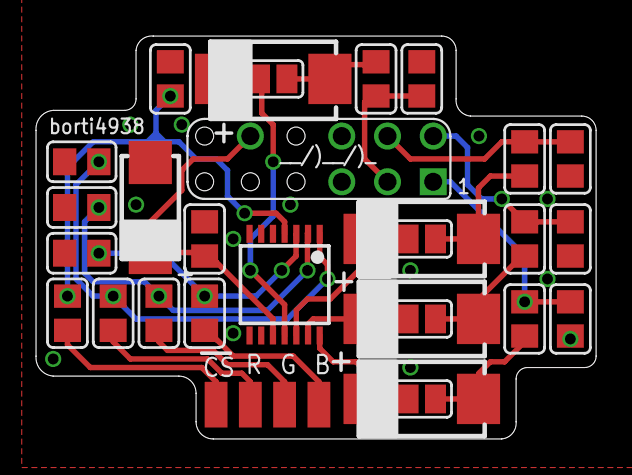
[picture p84: board SNES_RGBAmp_1Chip03+.brd from above]

Board: 2 copper layers, 31.1 x 22.4 mm, 32 parts (0 on the bottom side), 22 nets.
