phreakwiz/SNES-AddOn-PCBs/RGB Bypass/3Chip-SNES/SNES_RGBAmp_PAL/SNES_RGBAmp.brd

## EAGLE design RGB Bypass/3Chip-SNES/SNES_RGBAmp_PAL/SNES_RGBAmp.brd (2016-04-22, an earlier design)

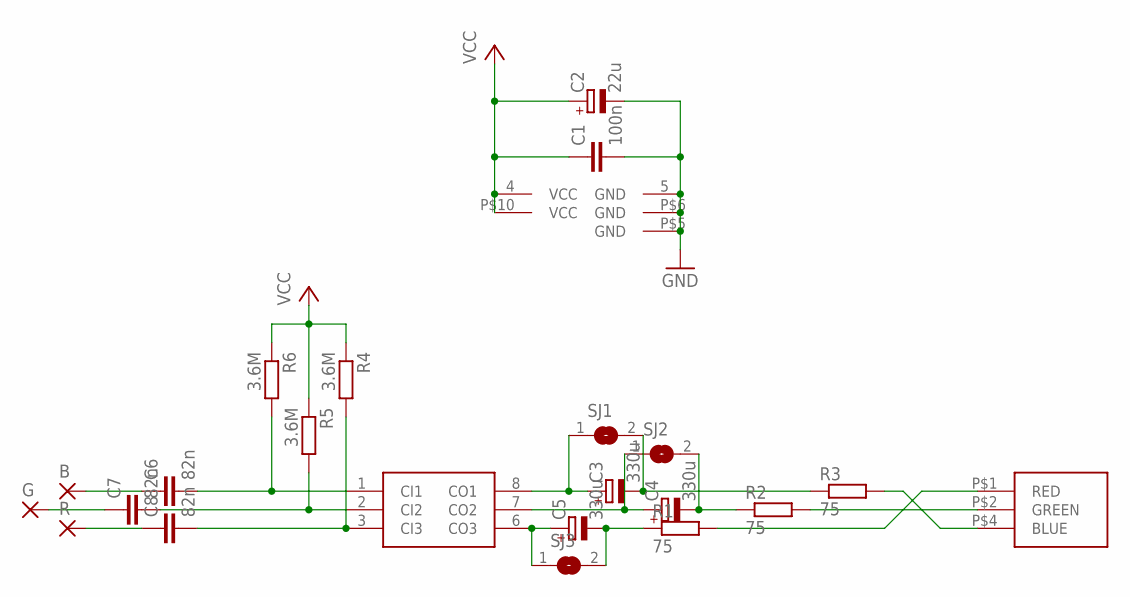
[picture p85: schematic SNES_RGBAmp.sch]

Parts:
B: SMD2; SMD1,27-2,54
C1: 100n; Z0805
C2: 22u; SMC_C
C3, C4, C5: 330u; SMC_D
C6, C7, C8: 82n; Z0805
G: SMD2; SMD1,27-2,54
R: SMD2; SMD1,27-2,54
R1, R2, R3: 75; Z0805
R4, R5, R6: 3.6M; Z0805
SJ1, SJ2, SJ3: SJ
U$1: THS7314
U$2: SNES_MULTIAV_RGB_ONLY

Connections:
GND: C1.2, C2.-, U$1.5 (GND), U$2.P$5 (GND), U$2.P$6 (GND)
unnamed: C6.2, R6.2, U$1.1 (CI1)
unnamed: C7.2, R5.2, U$1.2 (CI2)
unnamed: C8.2, R4.2, U$1.3 (CI3)
unnamed: C3.-, R3.1, SJ1.2
unnamed: R3.2, U$2.P$4 (BLUE)
unnamed: R2.2, U$2.P$2 (GREEN)
unnamed: C4.+, SJ2.1, U$1.7 (CO2)
unnamed: C5.-, R1.1, SJ3.2
unnamed: R1.2, U$2.P$1 (RED)
unnamed: C5.+, SJ3.1, U$1.6 (CO3)
unnamed: C3.+, SJ1.1, U$1.8 (CO1)
unnamed: C4.-, R2.1, SJ2.2
unnamed: B.1, C6.1
unnamed: C7.1, G.1
unnamed: C8.1, R.1
VCC: C1.1, C2.+, R4.1, R5.1, R6.1, U$1.4 (VCC), U$2.P$10 (VCC)

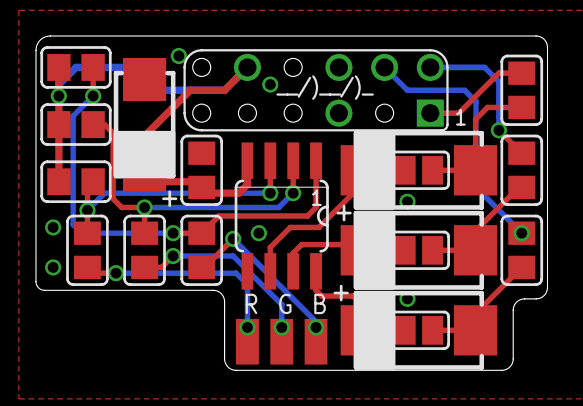
[picture p86: board SNES_RGBAmp.brd from above]

Board: 2 copper layers, 28.4 x 18.6 mm, 22 parts (0 on the bottom side), 17 nets.
