phreakwiz/SNES-AddOn-PCBs/Animated_Logo/SNES-logo-base.brd

## EAGLE design Animated_Logo/SNES-logo-base.brd (2015-08-26)

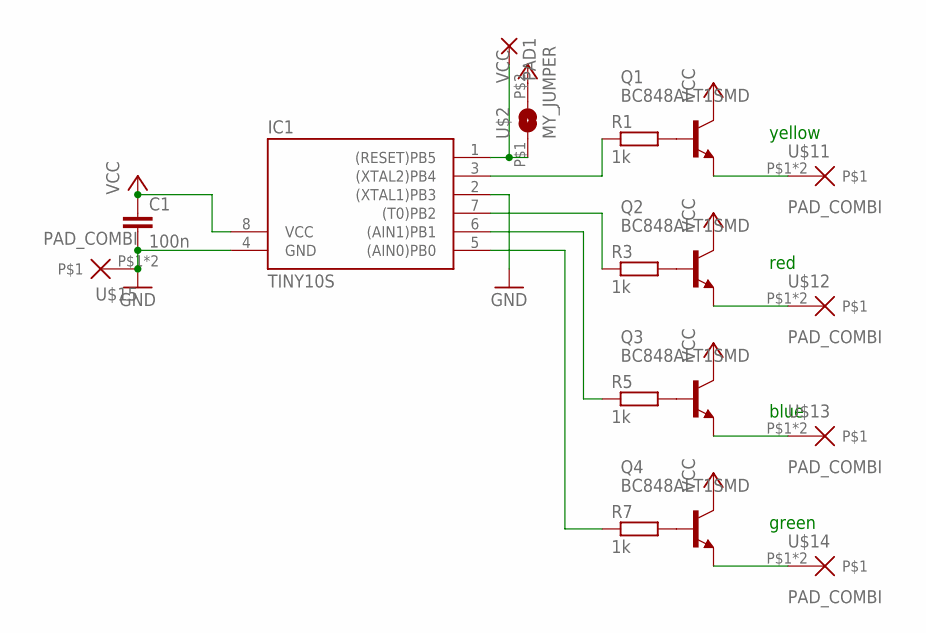
[picture p87: schematic SNES-logo-base.sch]

Parts:
C1: 100n; Z0805
IC1: TINY10S; SOIC8
PAD1: SMD2; SMD1,27-2,54
Q1, Q2, Q3, Q4: BC848ALT1SMD; SOT23
R1, R3, R5, R7: 1k; Z0805
U$2: MY_JUMPER; MYJUMP
U$11, U$12, U$13, U$14, U$15: PAD_COMBI

Connections:
GND: C1.2, IC1.2 ((XTAL1)PB3), IC1.4 (GND), U$15.P$1, U$15.P$2
unnamed: Q2.2 (E), U$12.P$1, U$12.P$2
unnamed: IC1.1 ((RESET)PB5), PAD1.1, U$2.P$1 (1)
unnamed: Q3.2 (E), U$13.P$1, U$13.P$2
unnamed: Q1.1 (B), R1.2
unnamed: Q2.1 (B), R3.2
unnamed: Q3.1 (B), R5.2
unnamed: Q4.1 (B), R7.2
unnamed: Q4.2 (E), U$14.P$1, U$14.P$2
unnamed: Q1.2 (E), U$11.P$1, U$11.P$2
unnamed: IC1.3 ((XTAL2)PB4), R1.1
unnamed: IC1.7 ((T0)PB2), R3.1
unnamed: IC1.6 ((AIN1)PB1), R5.1
unnamed: IC1.5 ((AIN0)PB0), R7.1
VCC: C1.1, IC1.8 (VCC), Q1.3 (C), Q2.3 (C), Q3.3 (C), Q4.3 (C), U$2.P$2 (2)

Notes on the sheet:
yellow
red
blue
green

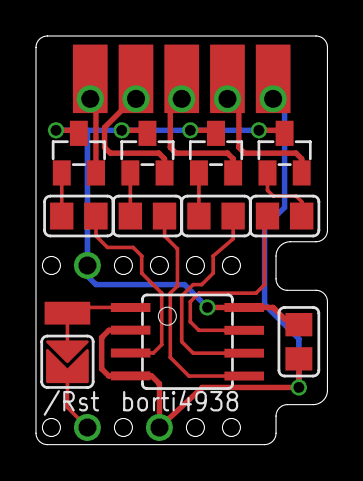
[picture p88: board SNES-logo-base.brd from above]

Board: 2 copper layers, 16.2 x 22.7 mm, 17 parts (0 on the bottom side), 15 nets.
