phreakwiz/SNES-AddOn-PCBs/Animated_Logo/SNES-logo-leds.brd

## EAGLE design Animated_Logo/SNES-logo-leds.brd (2015-08-26)

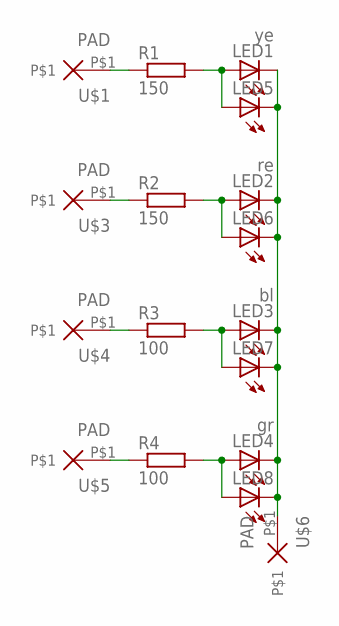
[picture p89: schematic SNES-logo-leds.sch]

Parts:
LED1: ye; SML0805
LED2: re; SML0805
LED3: bl; SML0805
LED4: gr; SML0805
LED5, LED6, LED7, LED8: LEDP-LCC-2; P-LCC-2
R1, R2: 150; Z0805
R3, R4: 100; Z0805
U$1, U$3, U$4, U$5, U$6: PAD

Connections:
unnamed: LED1.C, LED2.C, LED3.C, LED4.C, LED5.C, LED6.C, LED7.C, LED8.C, U$6.P$1
unnamed: R2.1, U$3.P$1
unnamed: LED1.A, LED5.A, R1.2
unnamed: R1.1, U$1.P$1
unnamed: R3.1, U$4.P$1
unnamed: R4.1, U$5.P$1
unnamed: LED2.A, LED6.A, R2.2
unnamed: LED3.A, LED7.A, R3.2
unnamed: LED4.A, LED8.A, R4.2

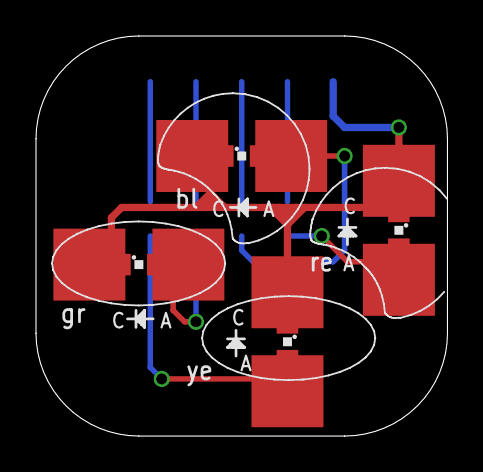
[picture p90: board SNES-logo-leds.brd from above]

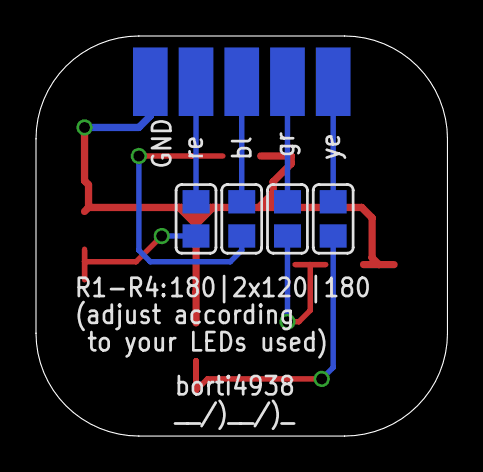
[picture p91: board SNES-logo-leds.brd from below]

Board: 2 copper layers, 22.9 x 22.2 mm, 17 parts (9 on the bottom side), 9 nets.
