phreakwiz/SNES-AddOn-PCBs/MultiRegion_with_DeJitter_QID/dfo/pcb_programmer/dfo_programmer_modified.brd

## EAGLE design MultiRegion_with_DeJitter_QID/dfo/pcb_programmer/dfo_programmer_modified.brd (2019-06-16)

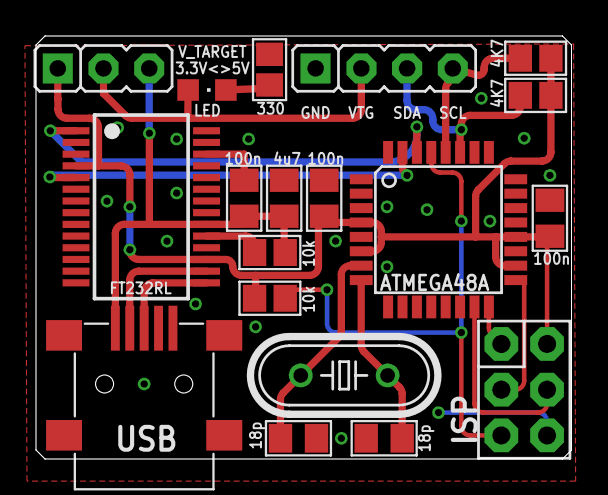
[picture p92: board dfo_programmer_modified.brd from above]

Board: 2 copper layers, 29.8 x 23.5 mm, 19 parts (0 on the bottom side), 18 nets.

Parts:
C1, C5, C6: 100n; C0805K_B
C2: 4u7; C0805K_B
C3, C4: 18p; C0805K_B
E$1: JP2
IC1: FT232RL; SSOP28
IC2: ATMEGA48A; TQFP32-08
JP1: JP3
LED: CHIPLED_0805
Q1: 10M; HC49/S
R1, R2: 10k; R0805_B
R3, R4: 4K7; R0805_B
R5: 330; R0805_B
U$2: ISPBIG_POGO_PINS; 2X3_ISP_BIGPOGO
USB1: LUMBERG2486_01_MINI_USB_B; LUM2486-01

Connections:
!RESET: IC2.29, R1.2, U$2.RESET
+3V3: C5.2, C6.2, E$1.1, IC1.4, IC1.17, IC2.4, IC2.6, IC2.18, IC2.20, R1.1, R3.2, R4.2, U$2.VCC
FT_RX: IC1.5, IC2.31
FT_TX: IC1.1, IC2.30
GND: C1.1, C2.1, C3.1, C4.1, C5.1, C6.1, IC1.7, IC1.18, IC1.21, IC1.25, IC1.26, IC2.3, IC2.5, IC2.21, JP1.1, R5.2, U$2.GND, USB1.5GND
unnamed: LED.C, R5.1
unnamed: C1.2, C2.2, E$1.3, IC1.20, R2.2, USB1.1VBUS
unnamed: IC1.19, R2.1
unnamed: C3.2, IC2.7, Q1.2
unnamed: C4.2, IC2.8, Q1.1
unnamed: IC2.16, U$2.MISO
unnamed: IC2.17, U$2.SCK
unnamed: IC2.15, U$2.MOSI
S$2: IC2.27, JP1.3, R3.1
SCL: IC2.28, JP1.4, R4.1
USB+: IC1.15, USB1.3D+
USB-: IC1.16, USB1.2D-
V_TARGET: E$1.2, JP1.2, LED.A
