phreakwiz/SNES-AddOn-PCBs/1Chip-Audio-DAC/1Chip-Audio-DAC.brd

## EAGLE design 1Chip-Audio-DAC/1Chip-Audio-DAC.brd (2018-05-26)

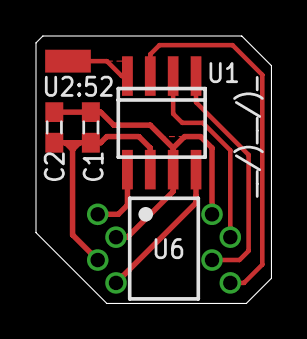
[picture p93: board 1Chip-Audio-DAC.brd from above]

Board: 2 copper layers, 13.1 x 14.9 mm, 4 parts (0 on the bottom side), 3 nets.

Parts:
C1: 0.1u; C0603
C2: 1u; C0603
MCLK: SMD1,27-2,54
U1: CS4338-KSZ; SO-08

Connections:
AGND: C1.1, C2.1, U1.6
MCLK: MCLK.1, U1.4
VA: C1.2, C2.2, U1.7
