phreakwiz/SNES-AddOn-PCBs/(commit log)

2015-08-07 Minor improvement I forgot about the SGB support. With the SGB specific controller reading the validity test fails if RAIF is cleared after the reading button B.
2015-08-26 Minor updates for the Logo-PCBs: - move resistors for LEDs to the LED PCB - LEDs can be either in 0805 or P-LCC-2 package
    [SNES-logo-base.brd, SNES-logo-base.sch, SNES-logo-leds.brd, SNES-logo-leds.sch]
2015-09-25 Code Backup for ATTiny45
    - created by jensma 2012 (jensam.de)
    - ported to atmel studio by sanni 2013
    - modified by borti4938 2015
    Code runs best at 8MHz
    use code in *_on_* folder if you want the LEDs to be on after animation
    use code in *_off_* folder if you want the LEDs to be switched off after animation
2015-10-15 Update Design: - minor changes and adjustments
    [SNES_SCIC_IGR_D4.brd, SNES_SCIC_IGR_D4.sch, SNES_SCIC_IGR_D4_Takt.brd, SNES_SCIC_IGR_D4_Takt.sch]
2015-10-15 RGB Bypass Version Update: - adjustment of wires - mirrored positioning of R, G and B pad - exact values for resistors - add a version with CSYNC-buffering (for 1Chip03 boards and later) - more detai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
    [SNES_RGBAmp.brd, SNES_RGBAmp.sch, SNES_RGBAmp_1Chip03+.brd, SNES_RGBAmp_1Chip03+.sch]
2015-12-03 rename files
    [SNES-1Chip_MR_QID.brd, SNES-1Chip_MR_QID.sch, SNES-3Chip_MR_QID.brd, SNES-3Chip_MR_QID.sch]
2015-12-03 Minor Updates: - Dual design for crystals (SNES-1Chip_MR_QID only); SMD and THT crystals are now supported (If THT crystals are used, SMD pads have to isolated, manually.) - minor tweaks of traces - 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
    [SNES-1Chip_MR_QID.brd, SNES-1Chip_MR_QID.sch, SNES-3Chip_MR_QID.brd, SNES-3Chip_MR_QID.sch]
2015-12-18 Update: 330uF tantalum in CSYNC line at the output of the THS7374.
    [SNES_RGBAmp_1Chip03+.brd, SNES_RGBAmp_1Chip03+.sch]
2016-02-01 Update silkscreen
    [SNES_RGBAmp.brd, SNES_RGBAmp.sch, SNES_RGBAmp_1Chip03+.brd, SNES_RGBAmp_1Chip03+.sch]
2016-02-11 move R12 to avoid a slight overlapping between the PCB and a mounting screw in SNES Mini and SFC Jr.
    [SNES_RGBAmp_1Chip03+.brd]
2016-02-19 add part list for multi region boards in QID
2016-02-21 new folder structure
    [SNES_RGBAmp.brd, SNES_RGBAmp.sch, SNES_RGBAmp_1Chip03+.brd, SNES_RGBAmp_1Chip03+.sch]
2016-02-21 introduce RGB-amp for the 3Chip-SNES (PAL models only) with a THS7314
    [SNES_RGBAmp.brd, SNES_RGBAmp.sch]
2016-04-22 add thermals to ground pad (easier to solder) and reduce PCB size a bit
    [SNES-1Chip_MR_QID.brd, SNES-1Chip_MR_QID.sch, SNES-3Chip_MR_QID.brd, SNES-3Chip_MR_QID.sch]
2016-04-22 add gerber files for MR QID
2016-04-22 rename folders a bit, add thermals to GND pads
    [SNES_RGBAmp.brd, SNES_RGBAmp.sch, SNES_RGBAmp_1Chip03+.brd, SNES_RGBAmp_1Chip03+.sch]
2016-04-22 remove deprecated designs
    [digAudio-PLT131.brd, digAudio-PLT131.sch]
2016-04-22 update design: move GND pad
    [digAudio-PLT133.brd]
2016-10-18 Backup V3
    [SNES_RGBAmp.brd, SNES_RGBAmp.sch, SNES_RGBAmp_1Chip03+.brd, SNES_RGBAmp_1Chip03+.sch, SNES_RGB_in_pass.brd, SNES_RGB_in_pass.sch]
2016-10-18 Initial commit V4
    [SNES_RGBAmp.brd, SNES_RGBAmp.sch, SNES_RGBAmp_wCSYNC.brd, SNES_RGBAmp_wCSYNC.sch]
2016-11-07 Correct resistor values for brightness correction
2017-01-26 sd2snes to Rev.H Mod
    [sd2snes_revH.brd, sd2snes_revH.sch]
2017-02-13 go to version 4.1
    [SNES_RGBAmp.brd, SNES_RGBAmp_wCSYNC.sch, SNES_RGBAmp_wCSYNC_SVid.brd, SNES_RGBAmp_wCSYNC_SVid.sch]
2017-02-14 Change resistor values
    [SNES_RGBAmp.brd, SNES_RGBAmp.sch, SNES_RGBAmp_wCSYNC.brd, SNES_RGBAmp_wCSYNC.sch, SNES_RGBAmp_wCSYNC_SVid.brd, SNES_RGBAmp_wCSYNC_SVid.sch]
2017-11-17 Update README and BOM
    [BOM_SNES_RGB_bypass.xlsx]
2017-11-19 include some feedback. Thanks to shartqueefa (shmups forum user) for that :)
    [BOM_SNES_RGB_bypass.xlsx]
2017-11-23 clean up
    [SNES1Chip_SCIC_IGR_D4_Takt.brd, SNES1Chip_SCIC_IGR_D4_Takt.sch, SNES1Chip_SCIC_IGR_D4_Takt_SMD.brd, SNES1Chip_SCIC_IGR_D4_Takt_SMD.sch, SNES_AddOn1Chip.brd, SNES_AddOn1Chip.sch, SNES_Basic.brd, SNES_Basic.sch]
2017-12-07 revert a small copy n paste error
    [BOM_SNES_RGB_bypass.xlsx]
2018-01-24 added missing KiCad files
    [SNES-1Chip_MR_QID.kicad_pcb, SNES-1Chip_MR_QID.sch]
2018-02-12 update digital audio mod incl a new no-cut design with coax
    [BOM.xlsx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]
2018-02-14 PCB Update
    [BOM.xlsx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]
2018-02-16 small bugfix in values (MPNs were right)
    [BOM_SNES_RGB_bypass.xlsx]
2018-02-23 SNES 1Chip replacement
    [1Chip-Audio-DAC.brd]
2018-04-17 fix some bugs in BOM
    [BOM_SNES_RGB_bypass.xlsx]
2018-05-26 Minor typo bugfix. Thanks to Nope (twitter @Nohpuh)
    [1Chip-Audio-DAC.brd]
2019-06-10 move classic multi-region mod
    [SNES-1Chip_MR_QID.brd, SNES-1Chip_MR_QID.kicad_pcb, SNES-1Chip_MR_QID.sch, SNES-3Chip_MR_QID.brd, SNES-3Chip_MR_QID.sch]
2019-06-16 initial commit multi region pcb with dejitter included
    [BOM.xlsx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]
2019-06-19 rename folder of EAGLE gerber legacy format output (issue #7)
    [SNES_MR_DeJitter_QID.GBL, SNES_MR_DeJitter_QID.GBO, SNES_MR_DeJitter_QID.GBS, SNES_MR_DeJitter_QID.GKO, SNES_MR_DeJitter_QID.GTL, SNES_MR_DeJitter_QID.GTO, SNES_MR_DeJitter_QID.GTS, SNES_MR_DeJitter_QID.XLN]
2019-08-13 add installation readme for SNSP-CPU-01 and SNSP-CPU-02 boards
2019-08-14 PCB update: - double /CS.i pad - color carrier generate inside CPLD (trace removed) - replace resistor arrays by simple components - add footprint for resistor from SNES mainboard to have resistor no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
    [BOM.xlsx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]
2019-08-14 version typo removed
    [BOM.xlsx]
2020-03-22 update PCB design: - selectable sync level for the buffered output - video buffer for sync instead of transistor
    [BOM.xlsx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]
2020-03-25 update PCB design: - selectable sync level for the buffered output - video buffer for sync instead of transistor - color carrier fix applied - some GND between sub-carrier and master clock output
    [BOM.xlsx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]
