phreakwiz/SNES-AddOn-PCBs/(notices)

Notices in the files:
1Chip-Audio-DAC/1Chip-Audio-DAC.brd:
(c) 2018 Peter Bartmann
parts and their libraries:
SparkFun: Licensing: CC v3.0 Share-Alike You are welcome to use this library for commercial purposes.
